ylu98596/telescopic-folding-robotic-arm-gripper/docs/patent-document.pdf

说明书摘要

本发明公开了一种伸缩折叠机械臂夹爪及其伸缩夹持方法，其中一种伸缩折叠

机械臂夹爪，包括：伸缩折叠组件，以及设置在所述伸缩折叠组件上的机械夹

爪基座，所述机械夹爪基座上驱动设置有夹爪组件；所述伸缩折叠组件包括若

干层间隔设置的衔接板，间隔设置的所述衔接板之间预留有间隔区域，每一层

间隔区域内设置有相对设置的展收板组件，间隔设置的所述衔接板通过展收板

组件驱动连接，通过调整展收板组件之间的开合角度调整衔接板之间的间隔区

域的间距，驱动机械夹爪基座实现伸缩折叠。本发明公开了一种结构简单、易

于集成、适应性强且能够实现高精度和快速响应的伸缩折叠机械臂夹爪及其伸

缩夹持方法。

### 摘要附图

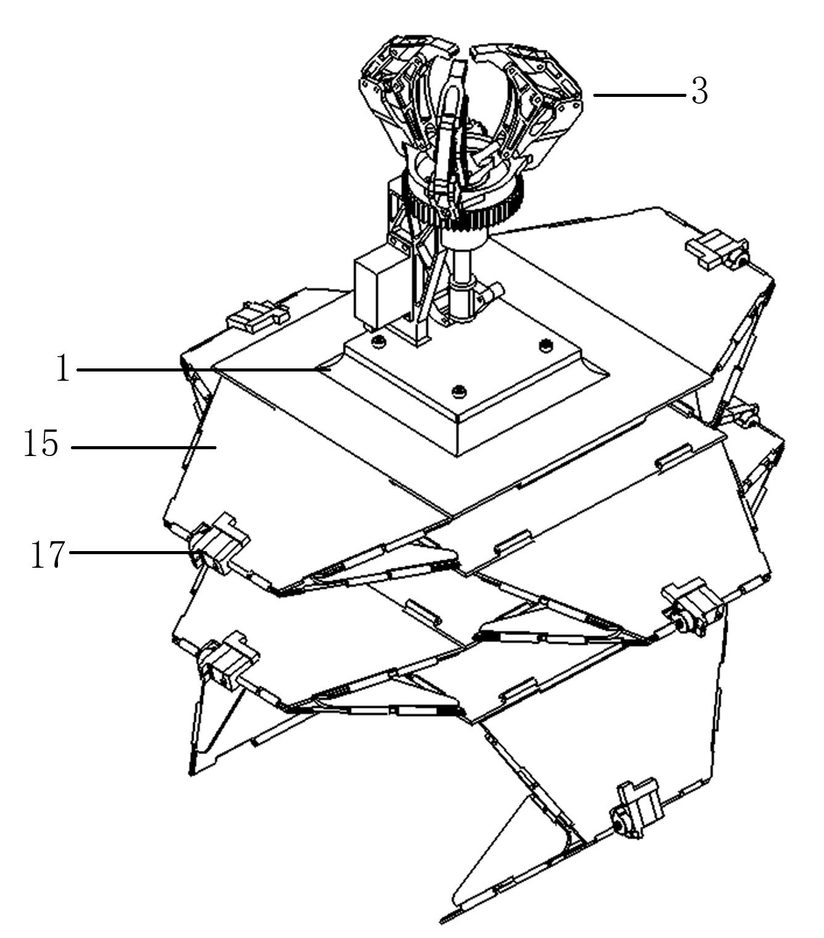
[picture p1: figure]

### 权利要求书

1.一种伸缩折叠机械臂夹爪，其特征在于,包括：伸缩折叠组件，以及设置

在所述伸缩折叠组件上的机械夹爪基座，所述机械夹爪基座上驱动设置有夹爪

组件；

所述伸缩折叠组件包括若干层间隔设置的衔接板，间隔设置的所述衔接板之

间预留有间隔区域，每一层间隔区域内设置有相对设置的展收板组件，间隔设

置的所述衔接板通过展收板组件驱动连接，通过调整展收板组件之间的开合角

度调整衔接板之间的间隔区域的间距，驱动机械夹爪基座实现伸缩折叠。

2.根据权利要求 1 所述的一种伸缩折叠机械臂夹爪，其特征在于：相邻的衔

接板之间的间隔区域的展收板组件交错排布。

3.根据权利要求 2 所述的一种伸缩折叠机械臂夹爪，其特征在于：所述展收

板组件包括通过展收舵机驱动连接的下展收板和上展收板，下展收板和上展收

板的另外一端分别连接间隔布置的衔接板的边沿，通过展收舵机驱动下展收板

和上展收板开合摆动，调整间隔布置的衔接板之间的间隔区域的间距。

4.根据权利要求 3 所述的一种伸缩折叠机械臂夹爪，其特征在于：展收板组

件还包括开合连接的上连接板和下连接板，

所述下展收板和上展收板相对开合的两侧边之间分别通过上连接板和下连

接板枢转连接。

5. 根据权利要求 4 所述的一种伸缩折叠机械臂夹爪，其特征在于：所述衔

接板采用的是方形板；

所述下展收板采用的是上梯形板，所述下连接板采用的是下梯形板，且所述

下展收板的短底边和下连接板的短底边枢转连接，所述下展收板的长底边和下

连接板的长底边分别与对应的衔接板的侧边连接；

所述上连接板采用的是上三角板，所述下连接板采用的是下三角板。

6.根据权利要求 5 所述的一种伸缩折叠机械臂夹爪，其特征在于：所述夹爪

### 权利要求书

组件包括设置在机械夹爪基座上的推拉舵机，所述推拉舵机上驱动连接有推拉

曲柄，推拉曲柄通过推拉臂与夹爪支架的驱动拉杆连接；

所述夹爪支架上设置有旋转舵机以及与所述旋转舵机驱动连接的主动齿轮

和夹爪齿轮；

所示夹爪齿轮上设置有爪座，所述爪座上连接有若干组能相对所述爪座中心

轴线开合的连杆，所述连杆的端部连接有夹爪，所述夹爪和连杆通过三角连杆

与夹爪支架驱动连接。

7.根据权利要求 6 所述的一种伸缩折叠机械臂夹爪，其特征在于：三角连杆

与夹爪支架铰链连接，连杆与爪座铰链连接，爪座与夹爪齿轮固定连接，推

拉曲柄与舵机连接，推拉臂与推拉曲柄、夹爪支架的驱动拉杆铰链。

8.一种伸缩折叠机械臂夹爪的伸缩夹持方法，其特征在于，采用权利要求 1~ 权利要求 7 中任一项所述的一种伸缩折叠机械臂夹爪实现，包括以下步骤：

通过驱动伸缩折叠组件中展收板组件的展收舵机，调整展收舵机连接的上展

收板和下展收板之间的开合角度，进而调整驱动伸缩折叠组件的伸缩形态，驱

动伸缩折叠组件上连接的机械夹爪基座位移至需求位置；

通过驱动机械夹爪基座上的夹爪组件中旋转舵机调整爪座的角度，通过驱动

推拉舵机连接的夹爪支架的驱动拉杆相对夹爪支架伸缩带动连杆、三角连杆、

夹爪联动，实现夹爪组件的夹持和释放。

9.根据权利要求 8 所述的一种伸缩折叠机械臂夹爪的伸缩夹持方法，其特征

在于：当推拉舵机驱动推拉曲柄顺时针旋转，带动推拉臂向上摆动，使夹爪支

架的驱动拉杆向上移动，带动三角连杆向外旋转，从而带动夹爪向外张开，实

现对物体的抓取；

当旋转舵机驱动主动齿轮旋转，带动夹爪齿轮同步旋转，从而带动机械夹

### 权利要求书

爪上部一起旋转，实现夹爪水平角度的调整。

10.根据权利要求 9 所述的一种伸缩折叠机械臂夹爪的伸缩夹持方法，其特

征在于：伸缩折叠组件中每一层包括一对相对设置的展收板组件，相对设置的

展收板组件中的展收舵机分别为左舵机和右舵机；

左舵机的转轴与旋转副连接，使得左舵机同时连接上展收板与下展收板，通

过给左舵机和右舵机分别提供 PWM 信号控制左舵机和右舵机的旋转角度，从而

控制上展收板与下展收板的开合角度。

### 说明书

一种伸缩折叠机械臂夹爪及其伸缩夹持方法

技术领域

本发明涉及机械臂技术领域，具体涉及一种伸缩折叠机械臂夹爪及其伸缩夹

持方法。

背景技术

在自动化和机器人技术中，机械臂的设计和应用至关重要。传统的机械臂往

往采用复杂的气压或液压系统，这些系统不仅结构复杂，占用空间大，不易于

运输和部署，而且对环境的适应性有限，灵活度不足，可重构性较差。

发明内容

本发明克服了现有技术的不足，提供了一种结构简单、易于集成、适应性强

且能够实现高精度和快速响应的伸缩折叠机械臂夹爪及其伸缩夹持方法。

为达到上述目的，本发明采用的技术方案为：一种伸缩折叠机械臂夹爪，包

括：伸缩折叠组件，以及设置在所述伸缩折叠组件上的机械夹爪基座，所述机

械夹爪基座上驱动设置有夹爪组件；所述伸缩折叠组件包括若干层间隔设置的

衔接板，间隔设置的所述衔接板之间预留有间隔区域，每一层间隔区域内设置

有相对设置的展收板组件，间隔设置的所述衔接板通过展收板组件驱动连接，

通过调整展收板组件之间的开合角度调整衔接板之间的间隔区域的间距，驱动

机械夹爪基座实现伸缩折叠。

本发明一个优选的实施方案中，相邻的衔接板之间的间隔区域的展收板组件

交错排布。

本发明一个优选的实施方案中，展收板组件包括通过展收舵机驱动连接的下

展收板和上展收板，下展收板和上展收板的另外一端分别连接间隔布置的衔接

板的边沿，通过展收舵机驱动下展收板和上展收板开合摆动，调整间隔布置的

衔接板之间的间隔区域的间距。

本发明一个优选的实施方案中，展收板组件还包括开合连接的上连接板和下

连接板，所述下展收板和上展收板相对开合的两侧边之间分别通过上连接板和

下连接板枢转连接。

本发明一个优选的实施方案中，衔接板采用的是方形板；所述下展收板采用

的是上梯形板，所述下连接板采用的是下梯形板，且所述下展收板的短底边和

下连接板的短底边枢转连接，所述下展收板的长底边和下连接板的长底边分别

与对应的衔接板的侧边连接；所述上连接板采用的是上三角板，所述下连接板

采用的是下三角板。

本发明一个优选的实施方案中，夹爪组件包括设置在机械夹爪基座上的推拉

舵机，所述推拉舵机上驱动连接有推拉曲柄，推拉曲柄通过推拉臂与夹爪支架

的驱动拉杆连接；

所述夹爪支架上设置有旋转舵机以及与所述旋转舵机驱动连接的主动齿轮

和夹爪齿轮；

所示夹爪齿轮上设置有爪座，所述爪座上连接有若干组能相对所述爪座中心

轴线开合的连杆，所述连杆的端部连接有夹爪，所述夹爪和连杆通过三角连杆

与夹爪支架驱动连接。

本发明一个优选的实施方案中，三角连杆与夹爪支架铰链连接，连杆与爪

座铰链连接，爪座与夹爪齿轮固定连接，推拉曲柄与舵机连接，推拉臂与推

拉曲柄、夹爪支架的驱动拉杆铰链。

本发明一个优选的实施方案中，一种伸缩折叠机械臂夹爪的伸缩夹持方法，

采用一种伸缩折叠机械臂夹爪实现，包括以下步骤：

通过驱动伸缩折叠组件中展收板组件的展收舵机，调整展收舵机连接的上展

收板和下展收板之间的开合角度，进而调整驱动伸缩折叠组件的伸缩形态，驱

动伸缩折叠组件上连接的机械夹爪基座位移至需求位置；

通过驱动机械夹爪基座上的夹爪组件中旋转舵机调整爪座的角度，通过驱动

推拉舵机连接的夹爪支架的驱动拉杆相对夹爪支架伸缩带动连杆、三角连杆、

夹爪联动，实现夹爪组件的夹持和释放。

本发明一个优选的实施方案中，当推拉舵机驱动推拉曲柄顺时针旋转，带动

推拉臂向上摆动，使夹爪支架的驱动拉杆向上移动，带动三角连杆向外旋转，

从而带动夹爪向外张开，实现对物体的抓取；当旋转舵机驱动主动齿轮旋转，

带动夹爪齿轮同步旋转，从而带动机械夹爪上部一起旋转，实现夹爪水平角

度的调整。

本发明一个优选的实施方案中，伸缩折叠组件中每一层包括一对相对设置的

展收板组件，相对设置的展收板组件中的展收舵机分别为左舵机和右舵机；

左舵机的转轴与旋转副连接，使得左舵机同时连接上展收板与下展收板，通

过给左舵机和右舵机分别提供 PWM 信号控制左舵机和右舵机的旋转角度，从而

控制上展收板与下展收板的开合角度。

本发明解决了技术背景中存在的缺陷，本发明有益的技术效果是：

一种伸缩折叠机械臂夹爪及其伸缩夹持方法，采用 PWM 信号控制伸缩折叠机

械臂夹爪的机械夹爪，能与外部设备互联实现人机交互，具有优异的自适应功

能。

1、本发明的伸缩折叠机械臂夹爪的结构简单，机械臂可活动范围大，移动

灵活。

2、本发明的伸缩折叠机械臂夹爪的折叠结构易于堆叠集成，不需要依赖气

压和液压系统的管路、阀门，也无需磁驱动所需的外部磁场。

3、本发明的伸缩折叠机械臂夹爪的控制方式简单，通过 PWM 信号控制动作，

降低了现有技术中机械臂夹爪的结果复杂性。

4、本发明的伸缩折叠机械臂夹爪适应性强，不受磁场强度、液压流量、压

力、环境温度等因素的影响；能实现高精度和快速响应，满足自动化和机器

人技术的需求，节约人力、物力、财力。

附图说明

下面结合附图和实施例对本发明进一步说明。

图 1 为本发明的优选实施例的一种可伸缩的折叠机械臂夹爪的机械夹爪结构

示意图；

图 2 为本发明的优选实施例的一种可伸缩的折叠机械臂夹爪的机械臂一个折

叠单元的结构示意图；

图 3 为本发明的优选实施例的一种可伸缩的折叠机械臂夹爪的机械臂结构示

意图；

图 4 为本发明的优选实施例的一种可伸缩的折叠机械臂夹爪的机械臂伸缩后

的结构示意图；

图 5 为本发明的优选实施例的一种可伸缩的折叠机械臂夹爪的机械臂伸缩后

的正视图；

图 6 为本发明的优选实施例的一种可伸缩的折叠机械臂夹爪的人机交互控制

流程图；

图 7 为本发明的优选实施例的手势识别与视觉反馈系统架构图；

图 8 为本发明的优选实施例的两个正方形板中心与两个舵机的二维切面图。

图中标号说明：1、机械夹爪基座；2、夹爪支架；3、夹爪；4、三角连杆；

5、连杆；6、爪座；7、主动齿轮；8、夹爪齿轮；9、旋转舵机；10、推拉舵机；

11、推拉曲柄；12、推拉臂；13、右舵机；14、衔接板；15、上展收板；16、

上连接板；17、左舵机；18、下展收板；19、下连接板。

具体实施方式

现在结合附图和实施例对本发明作进一步详细的说明，这些附图均为简化的

示意图，仅以示意方式说明本发明的基本结构，因此其仅显示与本发明有关的

构成。

需要说明，若本发明实施例中有涉及方向性指示(诸如上、下、底、顶等)，

则该方向性指示仅用于解释在某一特定姿态下各部件之间的相对位置关系、运

动情况等，如果该特定姿态发生改变时，则该方向性指示也相应地随之改变。

术语“第一”、“第二”仅用于描述目的，而不能理解为指示或暗示相对重要

性或者隐含指明所指示的技术特征的数量。由此，限定有“第一”、“第二”

的特征可以明示或者隐含地包括一个或者更多个该特征。除非另有明确的规定

和限定，术语“设置”、“相连”、“连接”应做广义理解，例如，可以是固

定连接，也可以是可拆卸连接，或一体地连接；可以是直接相连，也可以通过

中间媒介间接相连，可以是两个元件内部的连通。对于本领域的普通技术人员

而言，可以具体情况理解上述术语在本发明中的具体含义。

实施例一，如图 1-图 6 所示，一种伸缩折叠机械臂夹爪，包括：伸缩折叠组

件，以及设置在所述伸缩折叠组件上的机械夹爪基座 1，所述机械夹爪基座 1 上

驱动设置有夹爪组件。

具体的，伸缩折叠组件包括若干层间隔设置的衔接板 14，间隔设置的所述衔

接板 14 之间预留有间隔区域，每一层间隔区域内设置有相对设置的展收板组件，

间隔设置的所述衔接板 14 通过展收板组件驱动连接，通过调整展收板组件之间

的开合角度调整衔接板 14 之间的间隔区域的间距，驱动机械夹爪基座 1 实现伸

缩折叠。

展收板组件包括通过展收舵机驱动连接的下展收板 18 和上展收板 15，开合

连接的上连接板 16 和下连接板 19。下展收板 18 和上展收板 15 的另外一端分别

连接间隔布置的衔接板 14 的边沿，通过展收舵机驱动下展收板 18 和上展收板

15 开合摆动，调整间隔布置的衔接板 14 之间的间隔区域的间距。所述下展收板

18 和上展收板 15 相对开合的两侧边之间分别通过上连接板 16 和下连接板 19 枢

转连接。本实施例中，衔接板 14 采用的是方形板；所述下展收板 18 采用的是

上梯形板，所述下连接板 19 采用的是下梯形板，且所述下展收板 18 的短底边

和下连接板 19 的短底边枢转连接，所述下展收板 18 的长底边和下连接板 19 的

长底边分别与对应的衔接板 14 的侧边连接；所述上连接板 16 采用的是上三角

板，所述下连接板 19 采用的是下三角板。

具体的，夹爪组件包括设置在机械夹爪基座 1 上的推拉舵机 10，所述推拉舵

机 10 上驱动连接有推拉曲柄 11，推拉曲柄 11 通过推拉臂 12 与夹爪支架 2 的驱

动拉杆连接；所述夹爪支架 2 上设置有旋转舵机 9 以及与所述旋转舵机 9 驱动

连接的主动齿轮 7 和夹爪齿轮 8；所示夹爪齿轮 8 上设置有爪座 6，所述爪座 6

上连接有若干组能相对所述爪座 6 中心轴线开合的连杆 5，所述连杆 5 的端部连

接有夹爪 3，所述夹爪 3 和连杆 5 通过三角连杆 4 与夹爪支架 2 的驱动拉杆驱动

连接。其中，三角连杆 4 与夹爪支架 2 的驱动拉杆的一端铰链连接，连杆 5 与

爪座 6 铰链连接，爪座 6 与夹爪齿轮 8 固定连接，推拉曲柄 11 与推拉舵机 10

连接，推拉臂 12 与推拉曲柄 11、夹爪支架 2 的驱动拉杆的另一端铰链。

实施例二，在实施例一的基础上，相邻的衔接板 14 之间的间隔区域的展收板组

件交错排布。

实施例三，进一步的，本实施例二的基础上，力传感器型号选用现有技术中

的 TekscanFlexiForceA201 力传感器，安装在嵌入夹爪 3 的抓取面内侧。本实

施例中还设置有与伸缩折叠机械臂夹爪对应的深度摄像头，用于采集伸缩折叠

机械臂夹爪的姿态，深度摄像头型号选用 IntelRealSenseD455 深度摄像头，安

装在机械夹爪基座 1 的侧下方，镜头轴线与夹爪 3 中心线成 15°俯角。

实施例四，在实施例一或实施例二的基础上，一种伸缩折叠机械臂夹爪的伸

缩夹持方法，采用一种伸缩折叠机械臂夹爪实现，包括以下步骤：

通过驱动伸缩折叠组件中展收板组件的展收舵机，调整展收舵机连接的上展

收板 15 和下展收板 18 之间的开合角度，进而调整驱动伸缩折叠组件的伸缩形

态，驱动伸缩折叠组件上连接的机械夹爪基座 1 位移至需求位置。具体的，伸

缩折叠组件中每一层包括一对相对设置的展收板组件，相对设置的展收板组件

中的展收舵机分别为左舵机 17 和右舵机 13；左舵机 17 的转轴与旋转副连接，

使得左舵机 17 同时连接上展收板 15 与下展收板 18，通过给左舵机 17 和右舵机

13 分别提供 PWM 信号控制左舵机 17 和右舵机 13 的旋转角度，从而控制上展收

板 15 与下展收板 18 的开合角度。

通过驱动机械夹爪基座 1 上的夹爪组件中旋转舵机 9 调整爪座 6 的角度，通

过驱动推拉舵机 10 的夹爪支架 2 的驱动拉杆伸缩带动连杆 5、三角连杆 4、夹

爪 3 联动，实现夹爪组件的夹持和释放。具体的，当推拉舵机 10 驱动推拉曲柄

11 顺时针旋转，带动推拉臂 12 向上摆动，使夹爪支架 2 的驱动拉杆相对夹爪支

架 2 向上移动，带动三角连杆 4 向外旋转，从而带动夹爪 3 向外张开，实现对

物体的抓取；当旋转舵机 9 驱动主动齿轮 7 旋转，带动夹爪齿轮 8 同步旋转，

从而带动伸缩折叠机械臂夹爪上部一起旋转，实现夹爪 3 的水平角度的调整。

进一步的，左舵机 17 和右舵机 13 的旋转角度与上展收板 15 与下展收板 18

之间的夹角变化角度相等。伸缩实现：PWM 信号同时控制左舵机 17 与右舵机

13，控制两梯形板夹角一致切变化一致，实现折叠伸缩。弯曲实现：PWM 信号

同时控制左舵机 17 与右舵机 13，左舵机 17 使左边两梯形板夹角减小而右舵

机 13 使左边两梯形板夹角减小，从而实现左弯曲；右弯曲则反之；前后弯曲

则在上方或下方另一个维度的折叠单元上实现，从而达成 360°无死角的弯

曲。上连接板 16 与下连接板 19 在机械臂运动过程中辅助支撑，分担受力，

提升结构的稳定性。PWM 信号控制展收舵机（如从上到下所有的舵机）同时变

化相同角度实现快速伸缩弯曲。

实施例五，在实施例四的基础上，一种伸缩折叠机械臂夹爪的伸缩夹持方法，

采用一种伸缩折叠机械臂夹爪实现，还包括：

将单个元件理想化为一个旋转、伸缩的连杆，定义机械臂为四轴串联，求出

舵机角度与末端坐标的变换公式。以每个正方形的衔接板中心为坐标原点，垂

直于正方形的衔接板的为 z 轴正向；正视时，如图 5 中垂直于图片向外的为 y

轴，x 轴依照右手定则。相邻两块正方形板的衔接板的中心点位的连线作为算法

中的虚拟连杆，所有α角（包括α1、α2、α3、α4等）是相应层的正方形的衔

接板上的 z 轴与相应虚拟连杆之间的夹角，所有 l（包括 l1、l2、l3、l4等）是

相应虚拟连杆的长度。

第一个虚拟连杆：绕 x 轴旋转角度为α1，沿 z 轴伸缩长度为 l1；

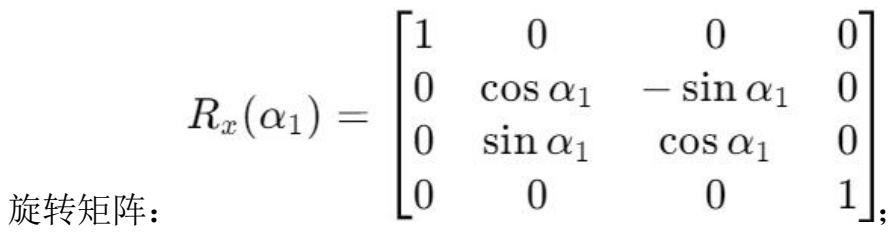
[picture p2: figure]
旋转矩阵：
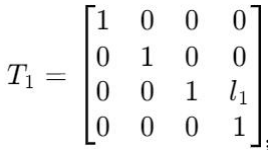
[picture p3: figure]

平移矩阵： | ；变换矩阵： | 。

第二个虚拟连杆：绕新的 y 轴旋转角度为α2，沿新 z 轴伸缩长度为 l2；

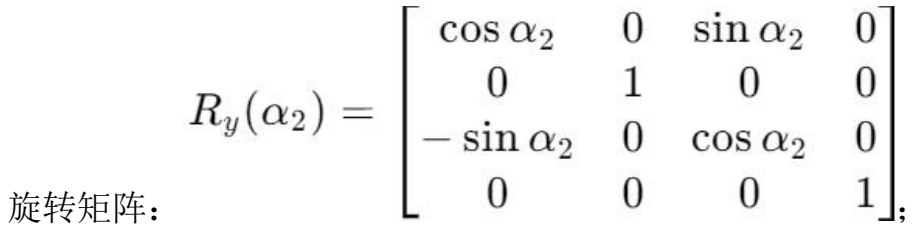
[picture p4: figure]
旋转矩阵：

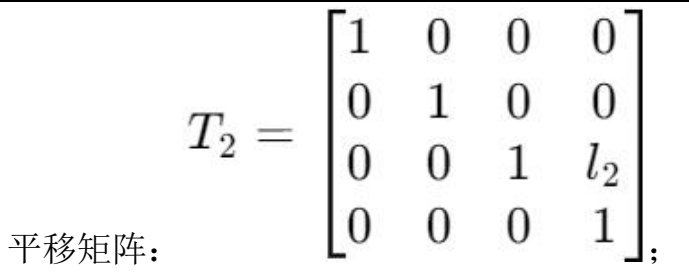
[picture p5: figure]
平移矩阵：

变换矩阵： | 。

第三个虚拟连杆：绕新的 x 轴旋转角度为α3，沿新 z 轴伸缩长度为 l3；

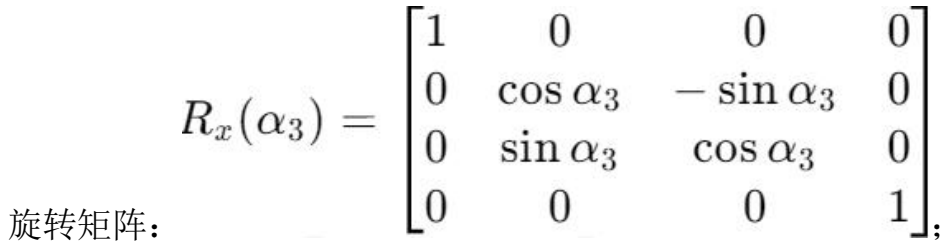
[picture p6: figure]
旋转矩阵：
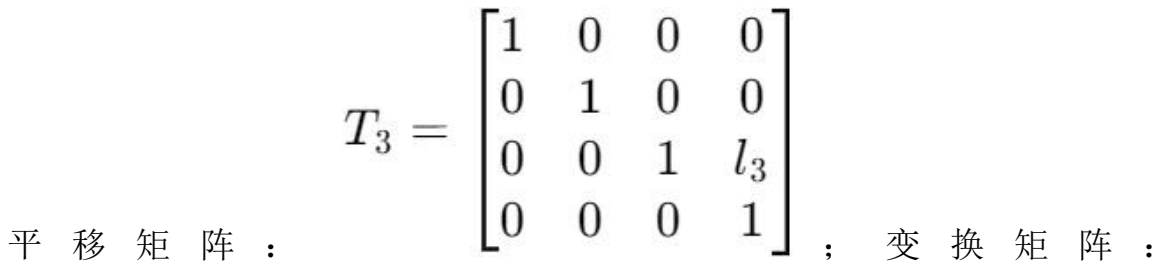
[picture p7: figure]

。

第四个虚拟连杆：绕新的 y 轴旋转角度为α4，沿新 z 轴伸缩长度为 l4；

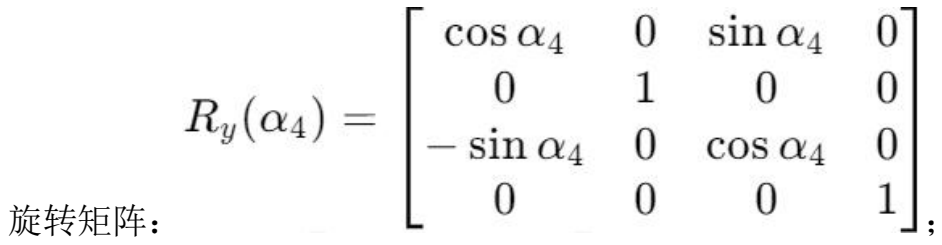
[picture p8: figure]
旋转矩阵：
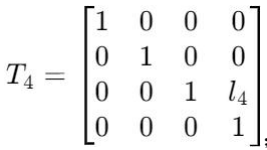
[picture p9: figure]

平移矩阵： | ；变换矩阵： | 。
从基座到末端执行器的总变换矩阵为： | ；
末端执行器坐标 | 为总变换矩阵 | 中前 3 行第 4 列的元素，

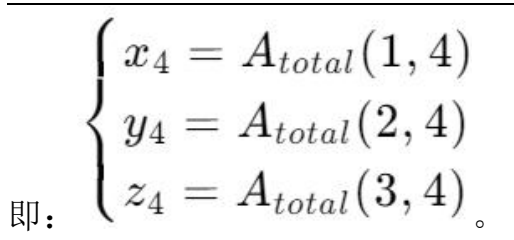
[picture p10: figure]

具体拟合推导数据如下：

对于单个元件，两个正方形板中心与两个舵机的二维切面图，如图 8 所示：

已知：AF=AB=CD=DE=a，BC=EF=b，O1M1=O1N1=c；∠FAB=θ1，∠EDC=θ 2；O1M1与 O1N1

分别是 BC 与 EF 的中垂线；

则，FH= | ÷
ø

ö
ç
è

æ
- 2

## a sin

θ1 ，EL= | ÷
ø

ö
ç
è

æ
- 2

## a sin

θ 2

；

则，N1K= | ú
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
## sin

2

## sin

2

a | θ1 | θ 2
；
则，M1N1=2N1K= | ú
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
## sin

2

## a sin

θ1 | θ 2 | , sin ∠N1O1D=N1K/O1N1= | ú

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
## sin

2

## sin

2

a | θ1 | θ 2
c
；
则∠N1O1D= | þ
| | ý

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
- - | 2

## sin

2

## sin

2

## sin

1 | θ1 | θ 2
c

a

；

由于虚拟连杆 1 为 M1N1；

α1 =- ∠ O1M1N1= ∠ N1O1D
2

π
- | = | þ ý

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
- - | 2

sin
2

sin
2

sin

1 | θ1 | θ 2
c

a
2

π
- ；

1

l =M1N1= | ú û

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
a sin

θ1 θ 2
；

以此类推：
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
æ = | · - | 2
sin
2

sin
2

sin

1 | 2
n
n | n c
a | θ | θ
α
2

π
- ； | ú
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
n | n

l a

θ | θ | ，

（n=1，2，3，4）；将
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
æ = | · - | 2
sin
2

sin
2

sin

1 | 2
n
n | n c
a | θ | θ
α | 与 | ú
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
n | n

l a

θ θ

求到的α n与 n

l 带入由各舵机夹角求出末端坐标的公式：

x4=l1sinα2sinα4cosα3+l2sinα4cosα3+l3sinα4cosα3+l4sinα4cosα3；

y4=l1(sinα1cosα2sinα4cosα3-cosα1sinα2sinα4cosα3)+l2(sinα1sinα

4cosα3+cosα1cosα4cosα3）+l3(sinα1sinα4cosα3+cosα1cosα4cosα3）

+l4(sinα1sinα4cosα3+cosα1cosα4cosα3）；

z4=l1(cosα1cosα2sinα4cosα3+sinα1sinα2sinα4cosα3)+l2(cosα1sinα

4cosα3-sinα1cosα4cosα3）+l3(cosα1sinα4cosα3-sinα1cosα4cosα3）

+l4(cosα1sinα4cosα3-sinα1cosα4cosα3）；

算出末端坐标 | 。

工作原理：

本发明提供了一种伸缩折叠机械臂夹爪及其伸缩夹持方法，包括机械夹爪、

折叠结构机械臂、舵机驱动单元及智能控制系统。折叠结构由多个铰接的正

方形板、梯形板和三角形板组成，通过 PWM 信号控制舵机驱动折叠单元伸缩、

弯曲和折叠，实现机械臂的高自由度运动。本发明采用 PWM 信号控制左舵机

使左边两梯形板夹角减小而右舵机使左边两梯形板夹角减小，从而实现左弯

曲；右弯曲则反之；前后弯曲则在上方或下方另一个维度的折叠单元上实现，

从而达成 360°无死角的弯曲。机械臂运动过程中辅助支撑，分担受力，提升

结构的稳定性。

本发明结构简单，机械臂可活动范围大，移动灵活；折叠结构易于堆叠集

成，而不需要气压和液压系统中的管路、阀门等复杂装置，也无需磁驱动所

需的外部磁场；控制系统简单，通过 PWM 信号即可实现精确控制降低了复杂

性；适应性强，不受磁场强度、液压流量、压力、环境温度等因素的影响；

能实现高精度和快速响应，满足自动化和机器人技术的需求，节约人力、物

力、财力。

以上具体实施方式是对本发明提出的方案思想的具体支持，不能以此限定本

发明的保护范围，凡是按照本发明提出的技术思想，在本技术方案基础上所做

的任何等同变化或等效的改动，均仍属于本发明技术方案保护的范围。

### 说明书附图

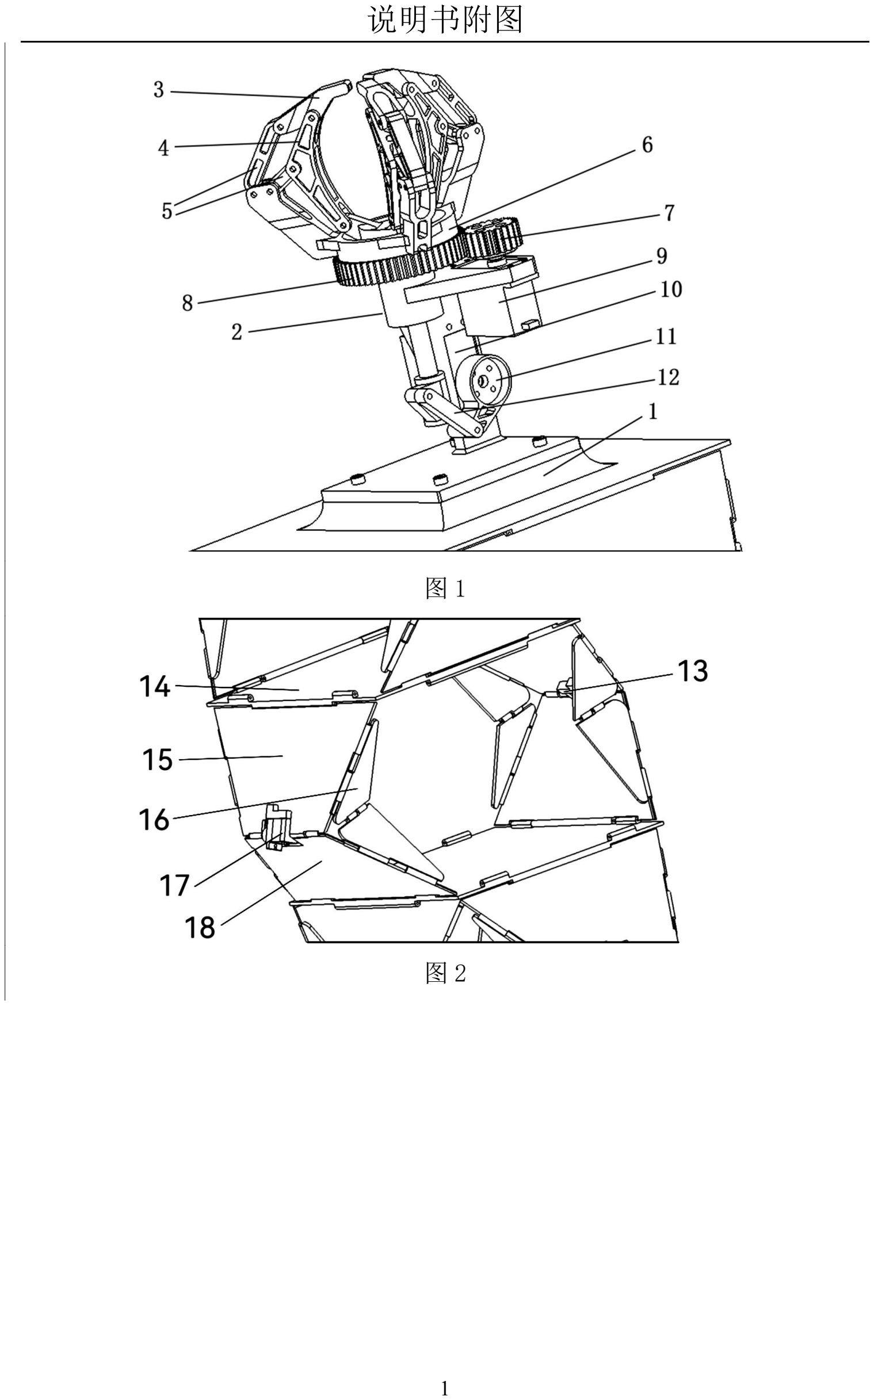
[picture p11: page 18]

图 1

图 2

### 说明书附图

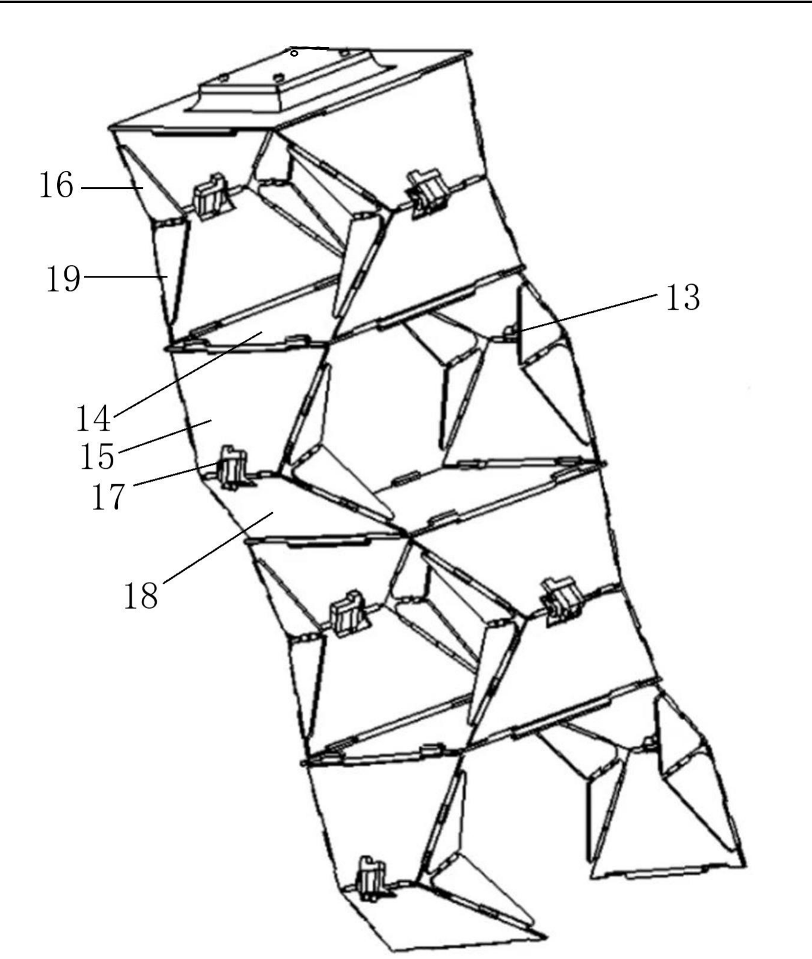
[picture p12: figure]

图 3

### 说明书附图

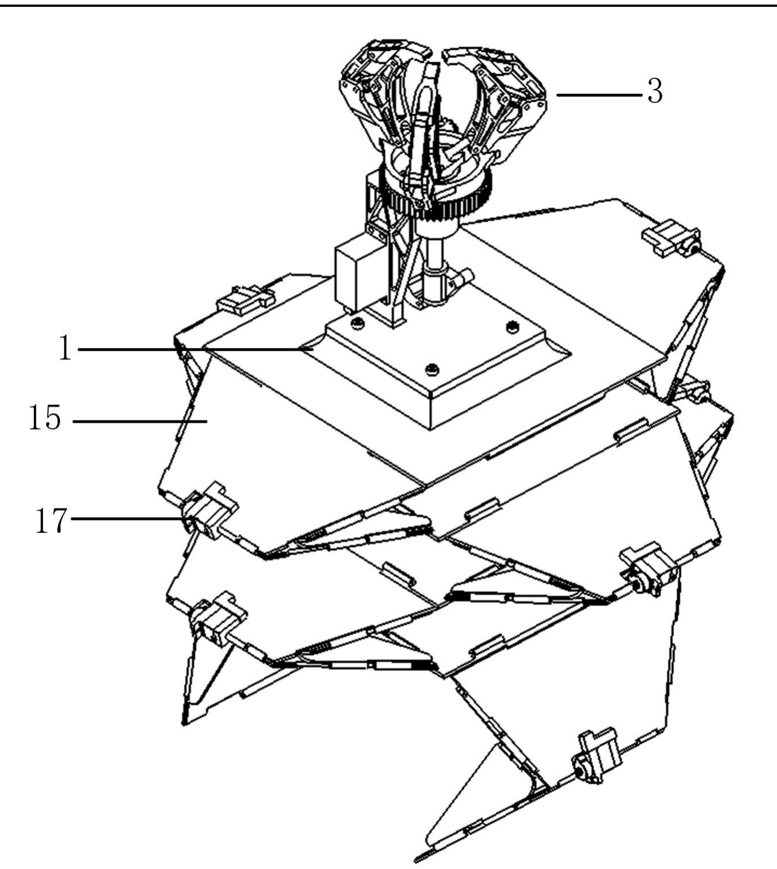
[picture p13: figure]

图 4

### 说明书附图

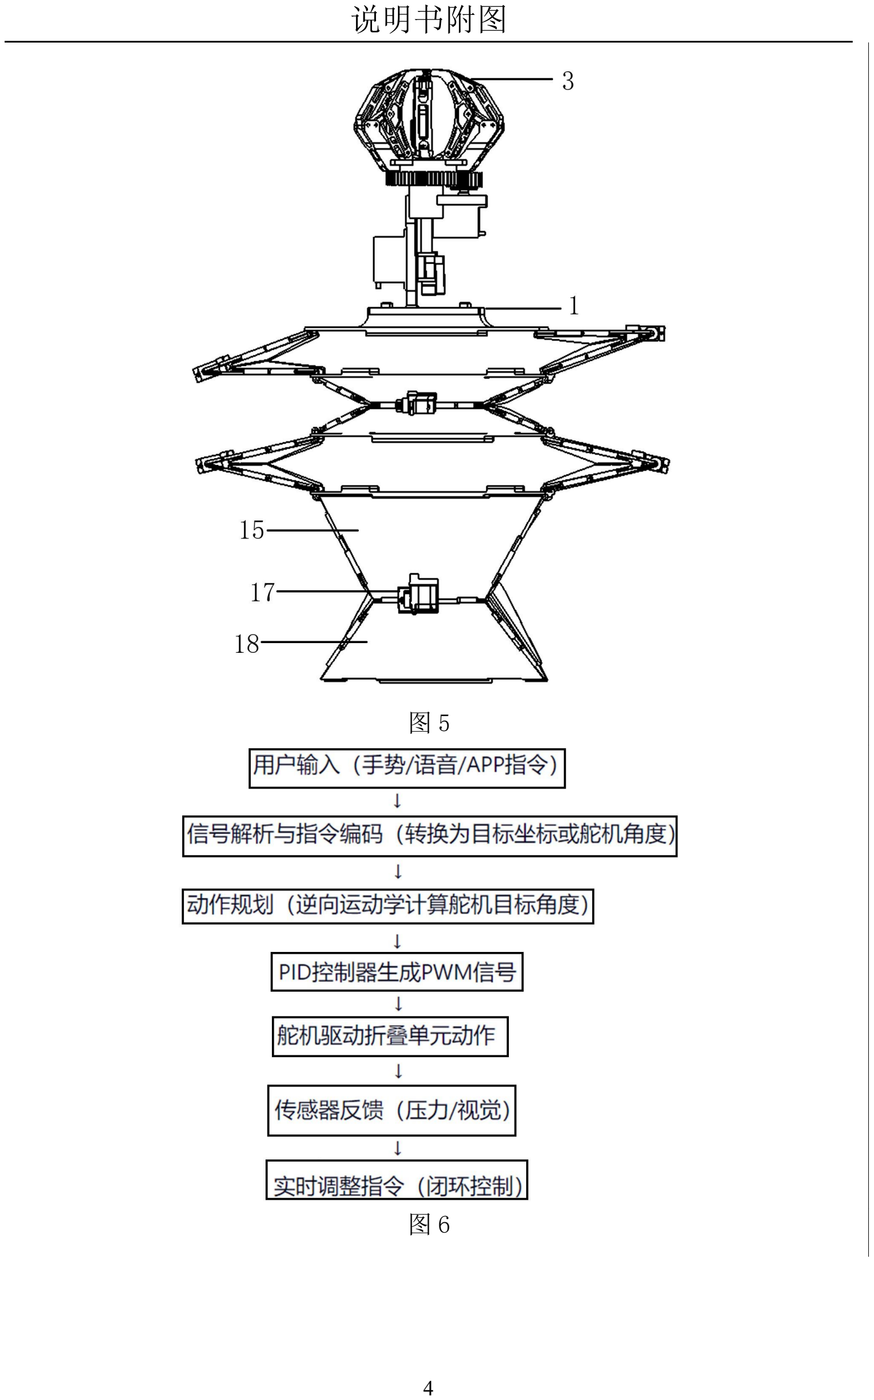
[picture p14: page 21]

图 5

图 6

### 说明书附图

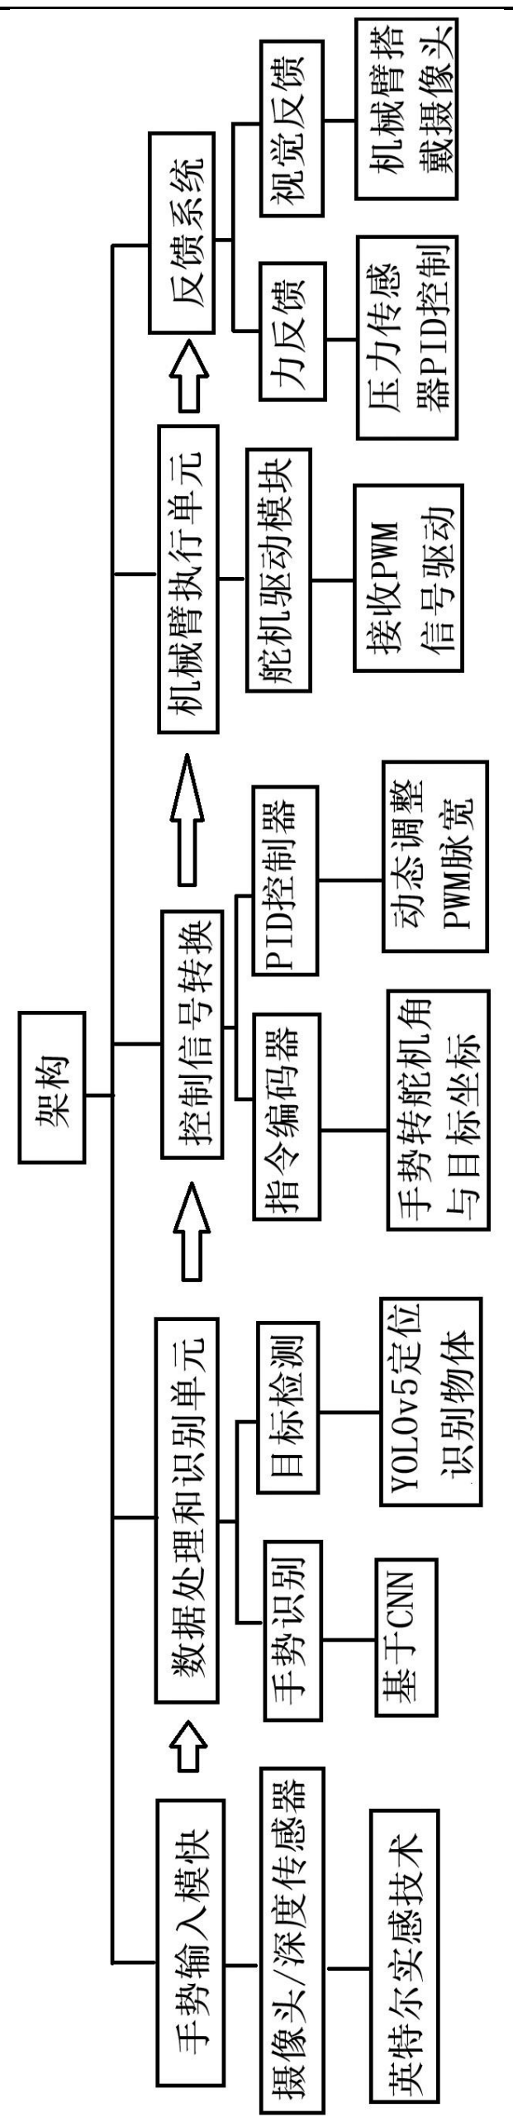
[picture p15: figure]

图 7

### 说明书附图

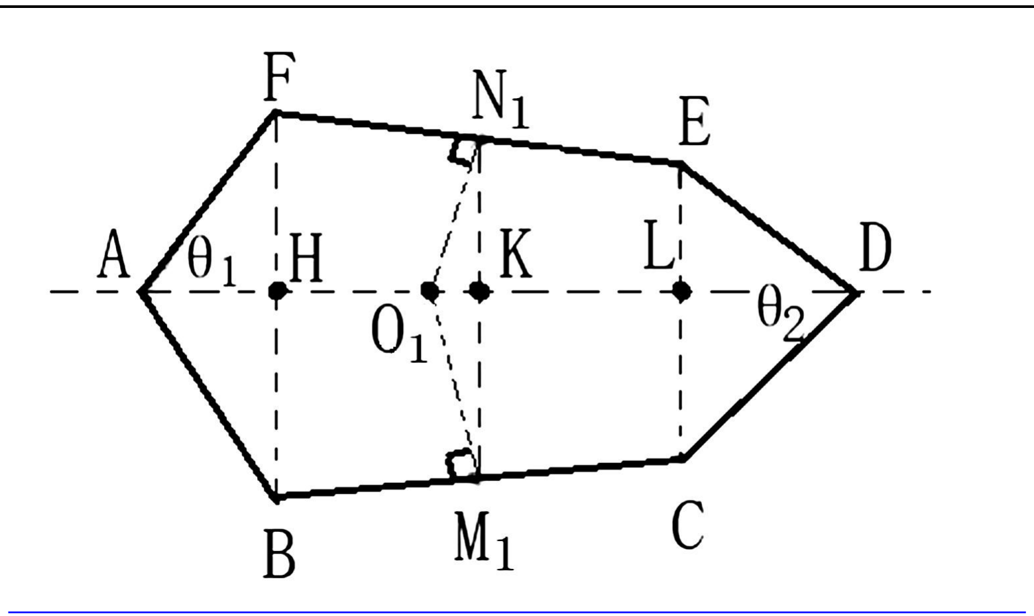
[picture p16: figure]

图 8
