ylu98596/telescopic-folding-robotic-arm-gripper/docs/patent-certificate.pdf

# 发 明 专 利 证 书

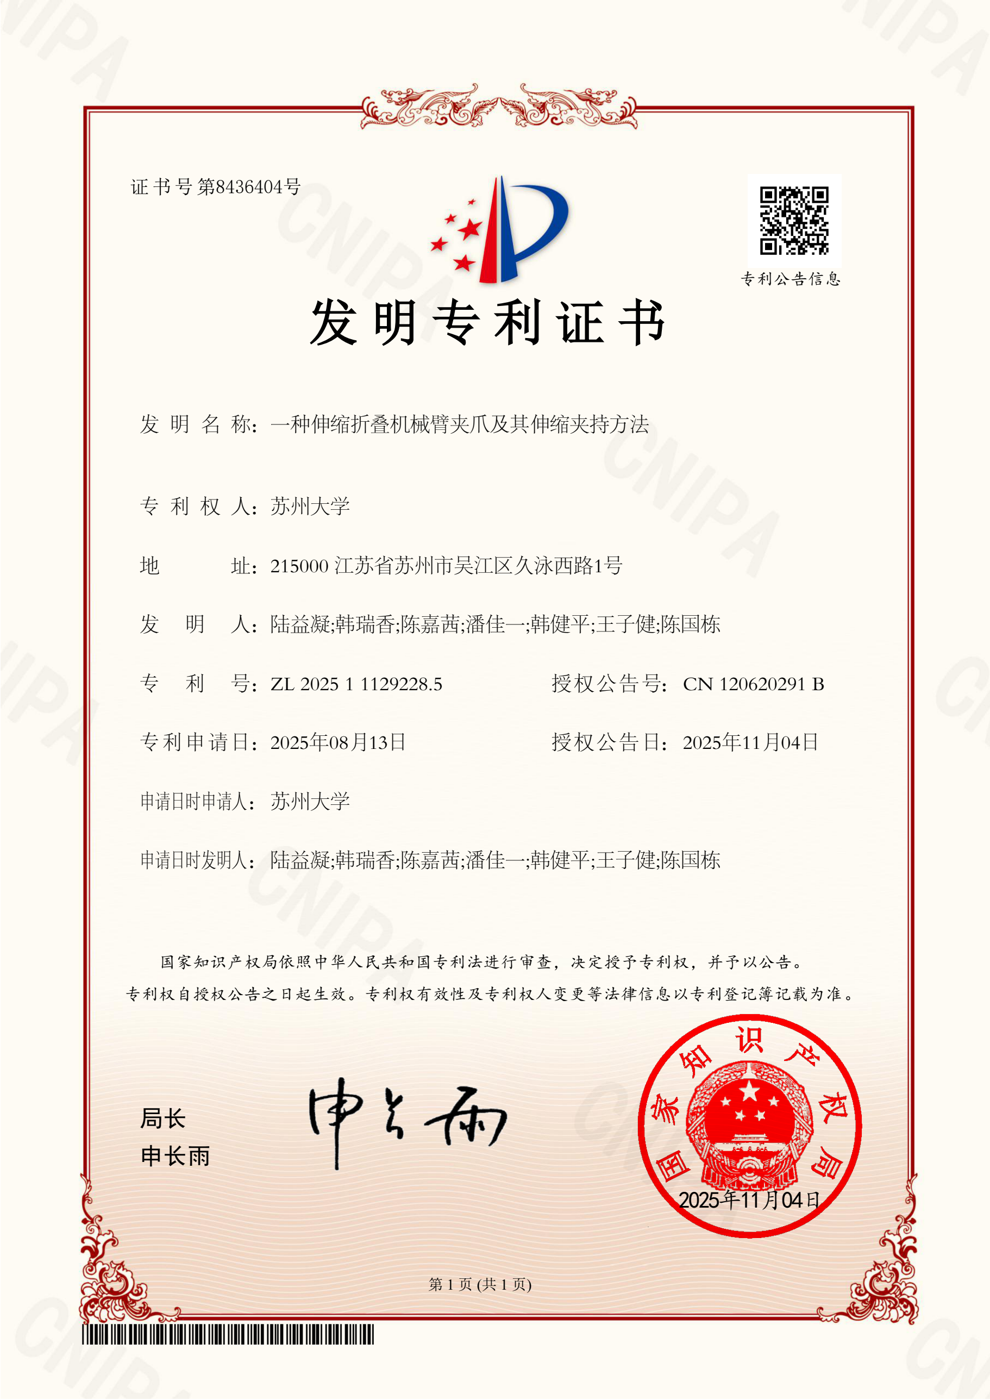
[picture p17: page 1]

第 1 页 (共 1 页)

证书号 第8436404号

专利公告信息

发 明 名 称：一种伸缩折叠机械臂夹爪及其伸缩夹持方法

专 利 权 人：苏州大学

地 | 址：215000 江苏省苏州市吴江区久泳西路1号
发 | 明 | 人：陆益凝;韩瑞香;陈嘉茜;潘佳一;韩健平;王子健;陈国栋
专 | 利 | 号：ZL 2025 1 1129228.5 | 授权公告号： CN 120620291 B
专 利 申 请 日：2025年08月13日 | 授权公告日： 2025年11月04日

申请日时申请人： 苏州大学

申请日时发明人： 陆益凝;韩瑞香;陈嘉茜;潘佳一;韩健平;王子健;陈国栋

国家知识产权局依照中华人民共和国专利法进行审查，决定授予专利权，并予以公告。

专利权自授权公告之日起生效。专利权有效性及专利权人变更等法律信息以专利登记簿记载为准。

局长
申长雨

2025年11月04日

*2025111292285*
