ylu98596/telescopic-folding-robotic-arm-gripper/images/1.png

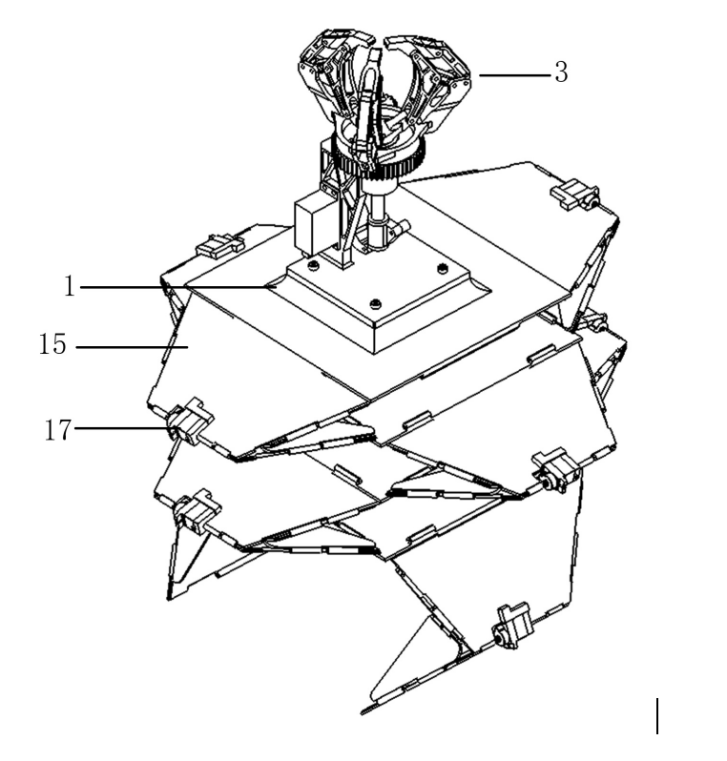
images/1.png
