ylu98596/telescopic-folding-robotic-arm-gripper/images/2.png

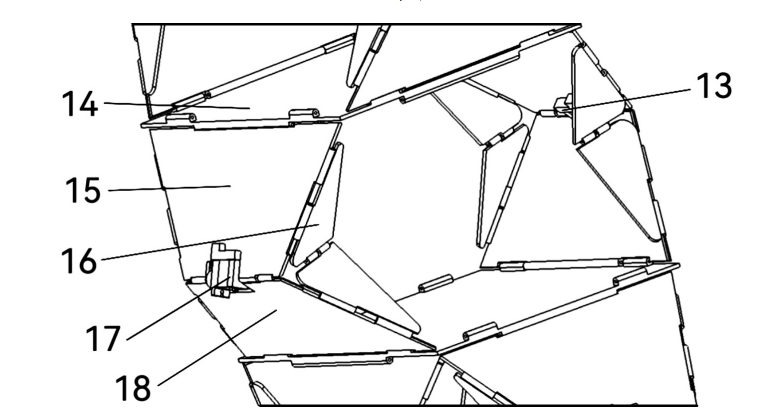
images/2.png
