ylu98596/telescopic-folding-robotic-arm-gripper/images/3.png

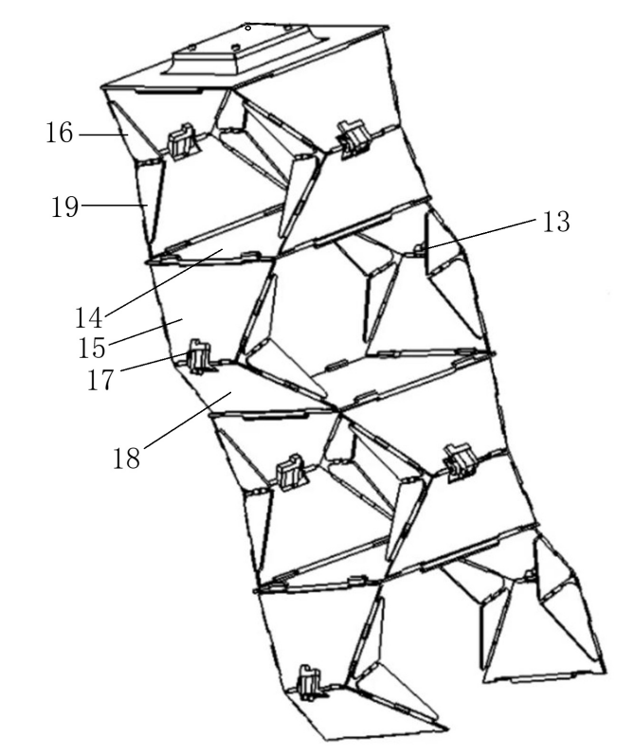
images/3.png
