ylu98596/telescopic-folding-robotic-arm-gripper/images/4.png

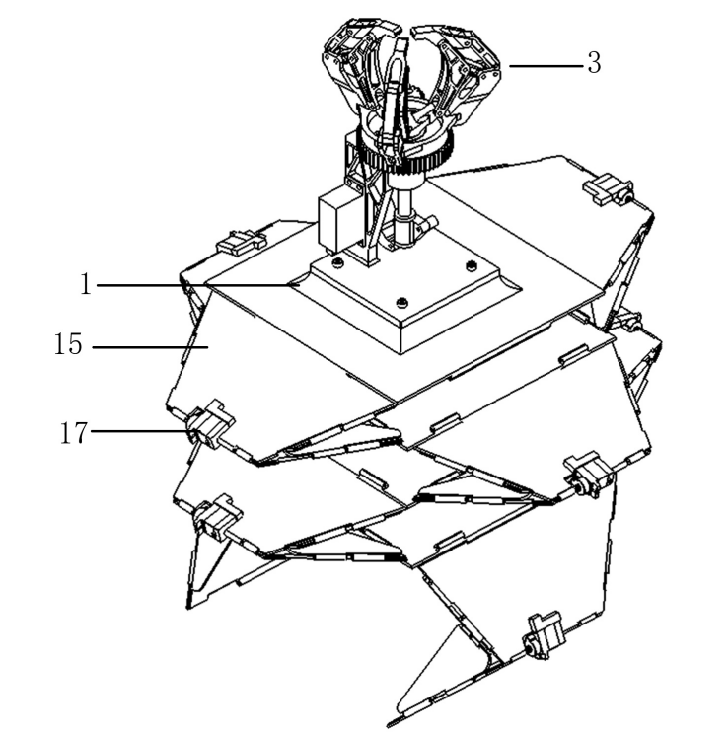
images/4.png
