ylu98596/telescopic-folding-robotic-arm-gripper/images/5.png

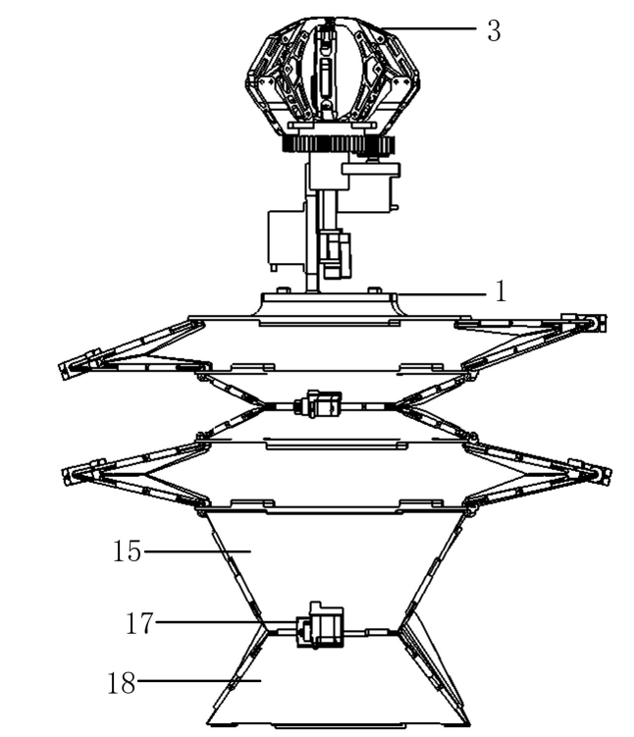
images/5.png
