ylu98596/telescopic-folding-robotic-arm-gripper/SW/机械臂.SLDASM

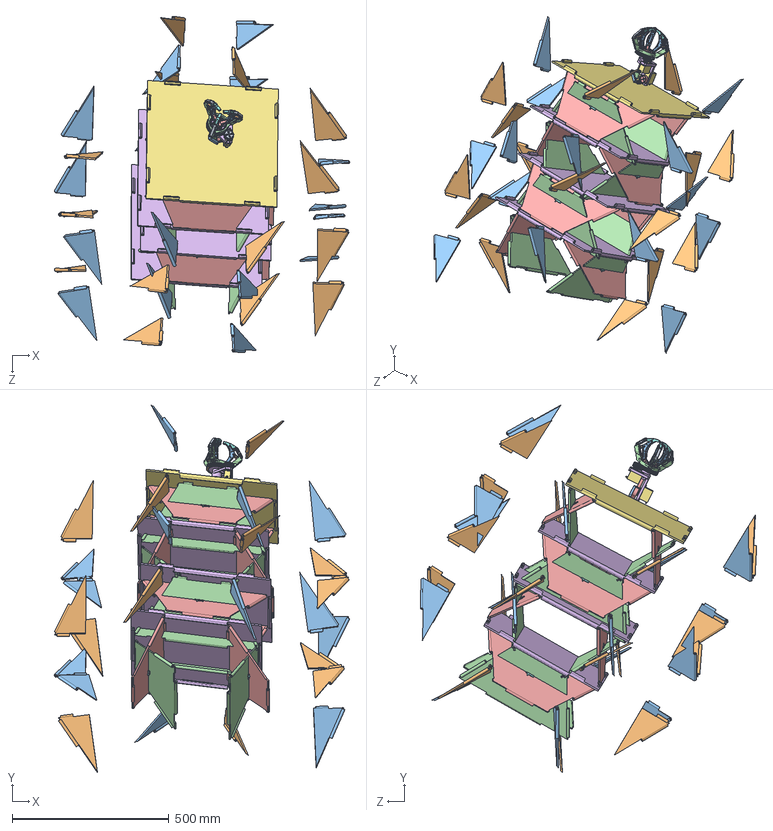
[picture p23: CAD file, 2026-10-07]
SW/机械臂.SLDASM
941.8 x 1172.7 x 1072.2 mm
正方形中间层 x 3
梯形上 x 8
梯形下 x 8
三角上 x 16
三角下 x 16
舵机架 x 8
9g舵机 x 8
正方形顶盖
机架 x 2
爪支架
爪座
三角连杆 x 3
连杆1 x 3
连杆2 x 3
草图 x 3
MG996舵机 x 2
舵盘 x 2
推拉曲柄
推拉臂
推拉臂2
圆柱齿轮55×1.25
圆柱齿轮23×1.25
