ylu98596/telescopic-folding-robotic-arm-gripper/SW/机械手臂/折叠机构部件2.SLDASM

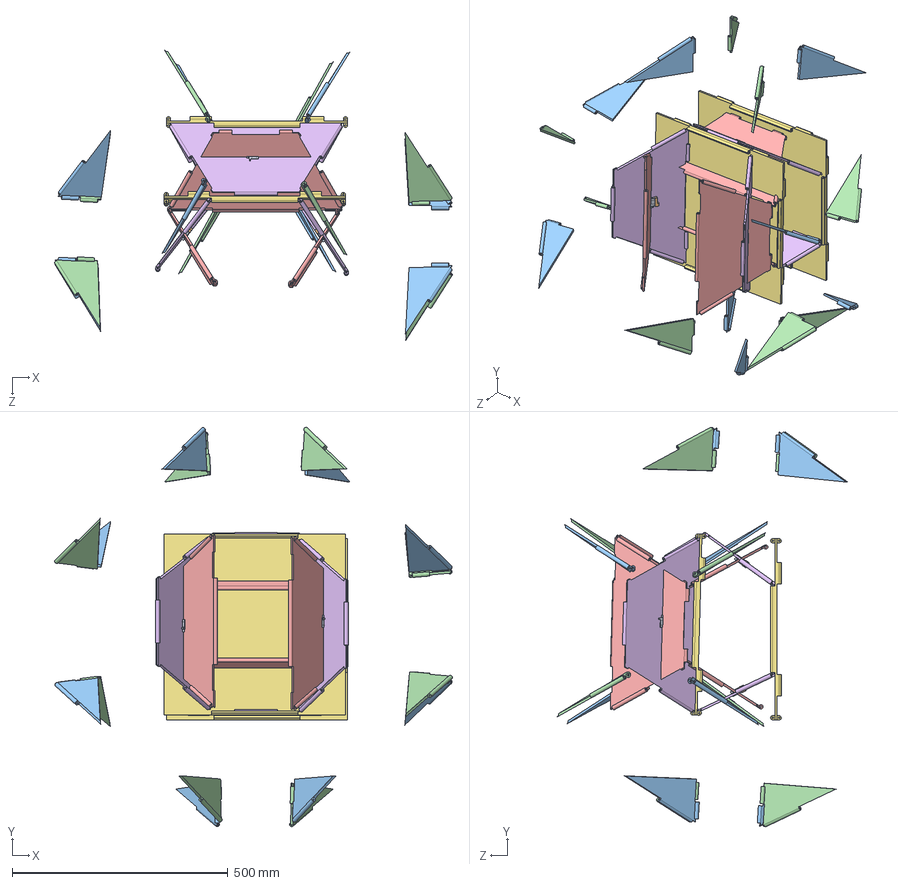
[picture p24: CAD file, 2026-10-07]
SW/机械手臂/折叠机构部件2.SLDASM
921.9 x 925.5 x 672.6 mm
正方形中间层 x 2
梯形上 x 4
梯形下 x 4
三角上 x 8
三角下 x 8
舵机架 x 4
9g舵机 x 4
