ylu98596/telescopic-folding-robotic-arm-gripper/SW/机械夹爪/机械手装配.SLDASM

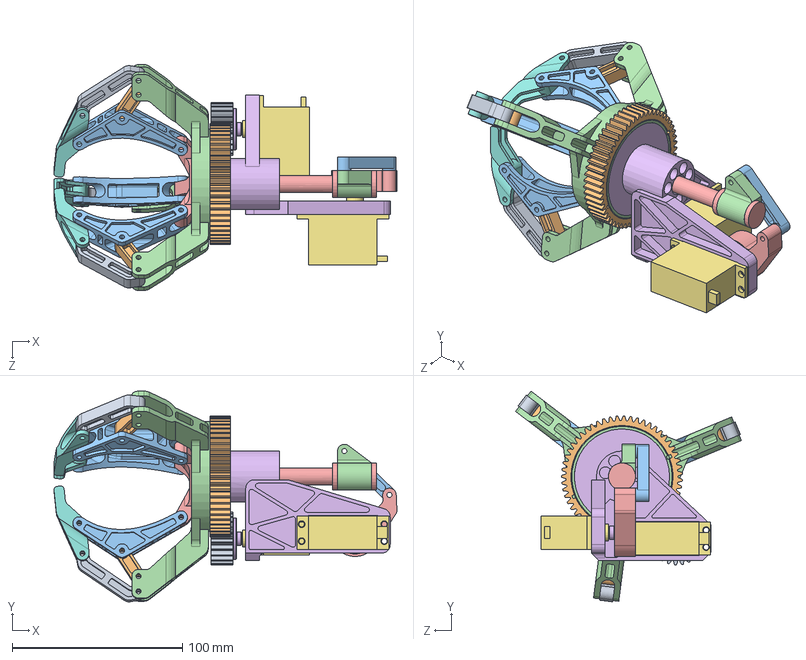
[picture p25: CAD file, 2026-10-07]
SW/机械夹爪/机械手装配.SLDASM
201.7 x 123.9 x 132.8 mm
机架 x 2
爪支架
爪座
三角连杆 x 3
连杆1 x 3
连杆2 x 3
草图 x 3
MG996舵机 x 2
舵盘 x 2
推拉曲柄
推拉臂
推拉臂2
圆柱齿轮55×1.25
圆柱齿轮23×1.25
