ylu98596/telescopic-folding-robotic-arm-gripper/SW/机械手臂/机械臂手臂部分.SLDASM

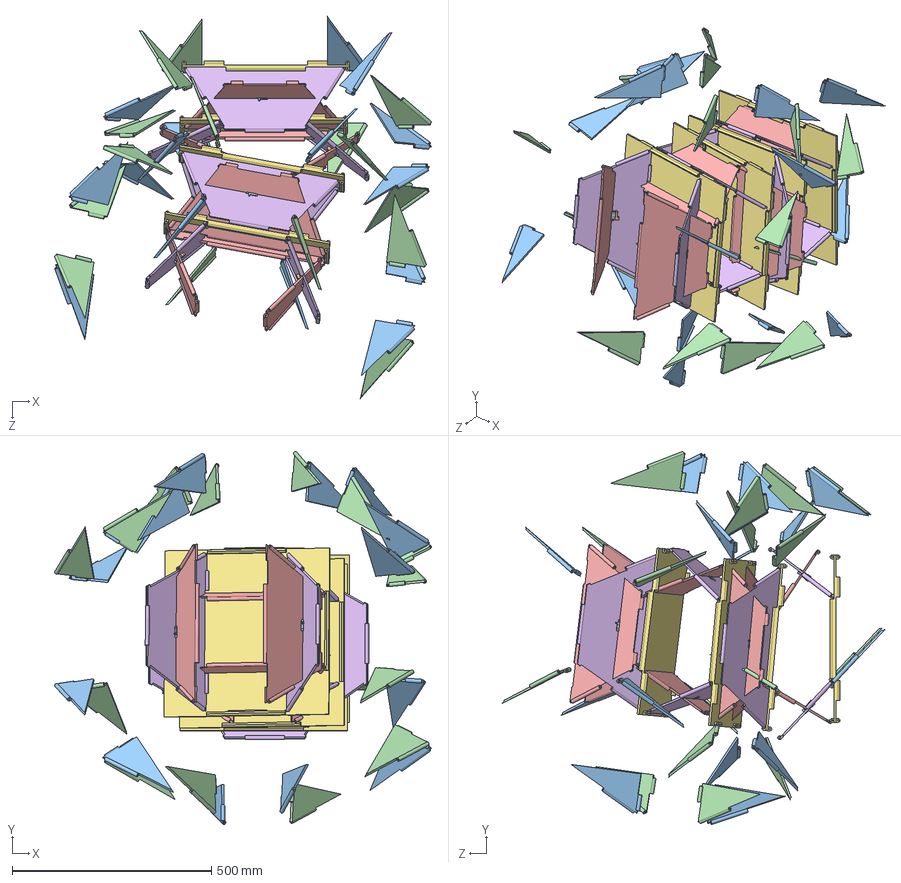
[picture p26: CAD file, 2026-10-07]
SW/机械手臂/机械臂手臂部分.SLDASM
946.0 x 936.1 x 958.6 mm
正方形中间层 x 4
梯形上 x 8
梯形下 x 8
三角上 x 16
三角下 x 16
舵机架 x 8
9g舵机 x 8
