ylu98596/telescopic-folding-robotic-arm-gripper/SW/机械手臂/折叠结构部件1.SLDASM

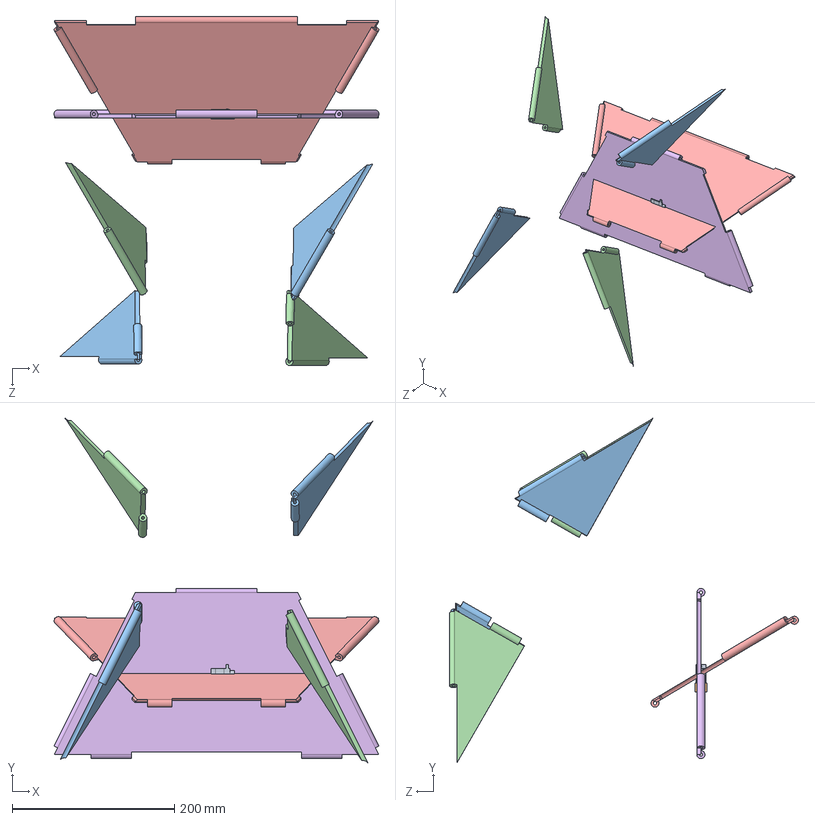
[picture p27: CAD file, 2026-10-07]
SW/机械手臂/折叠结构部件1.SLDASM
400.6 x 424.1 x 430.2 mm
梯形上
梯形下
三角上 x 2
三角下 x 2
舵机架
9g舵机
