ylu98596/telescopic-folding-robotic-arm-gripper/SW/机械夹爪/爪座.SLDPRT

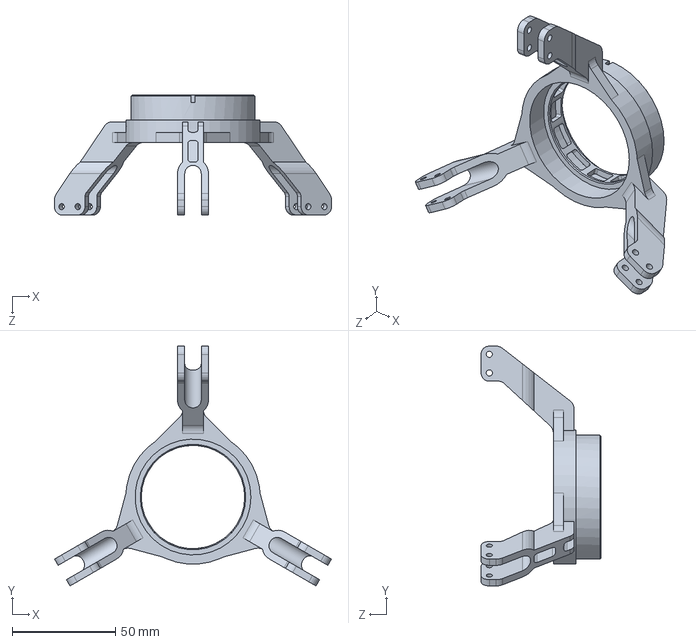
[picture p28: CAD file, 2026-10-07]
SW/机械夹爪/爪座.SLDPRT
133.9 x 116.0 x 58.0 mm
