ylu98596/telescopic-folding-robotic-arm-gripper/SW/机械夹爪/舵机及配件/MG996舵机.SLDPRT

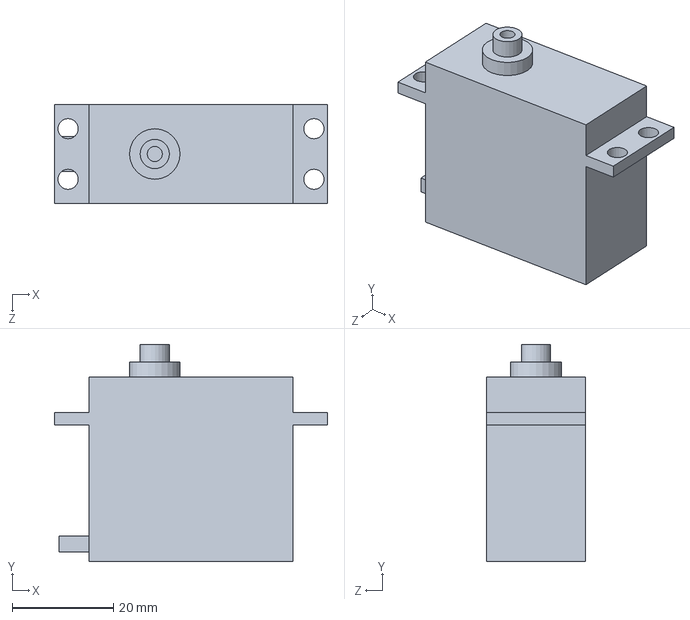
[picture p29: CAD file, 2026-10-07]
SW/机械夹爪/舵机及配件/MG996舵机.SLDPRT
54.0 x 43.0 x 19.5 mm
