ylu98596/telescopic-folding-robotic-arm-gripper/SW/机械手臂/正方形盖子.SLDPRT

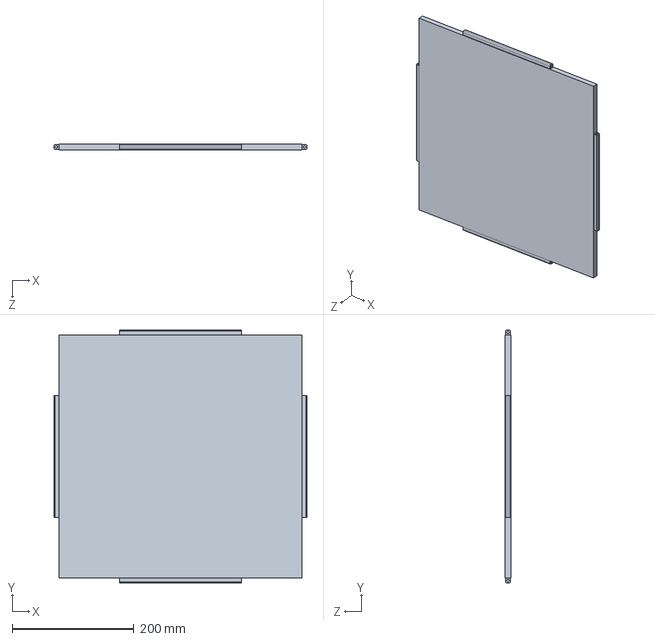
[picture p30: CAD file, 2026-10-07]
SW/机械手臂/正方形盖子.SLDPRT
416.0 x 416.0 x 10.0 mm
