ylu98596/telescopic-folding-robotic-arm-gripper/SW/机械夹爪/舵机及配件/舵盘.SLDPRT

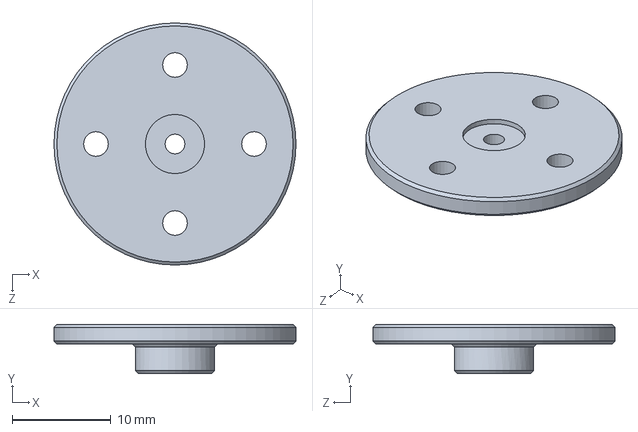
[picture p31: CAD file, 2026-10-07]
SW/机械夹爪/舵机及配件/舵盘.SLDPRT
24.5 x 5.00 x 24.5 mm
