ylu98596/telescopic-folding-robotic-arm-gripper/SW/机械夹爪/草图.SLDPRT

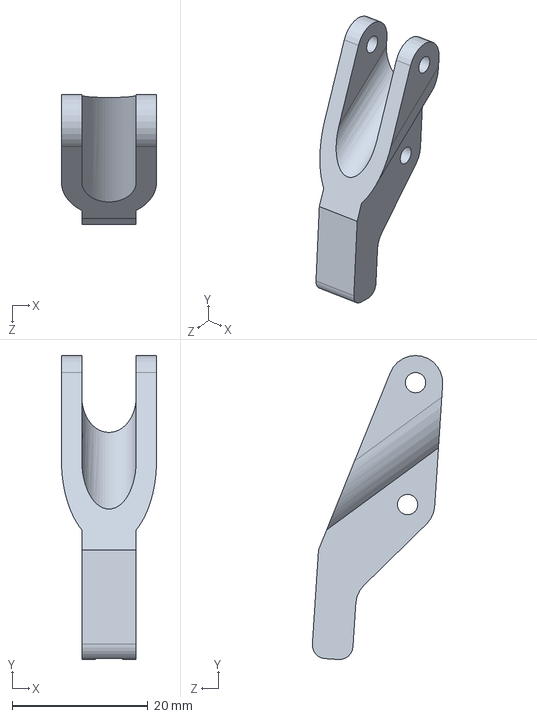
[picture p32: CAD file, 2026-10-07]
SW/机械夹爪/草图.SLDPRT
14.0 x 44.8 x 19.2 mm
