ylu98596/telescopic-folding-robotic-arm-gripper/SW/机械夹爪/连杆1.SLDPRT

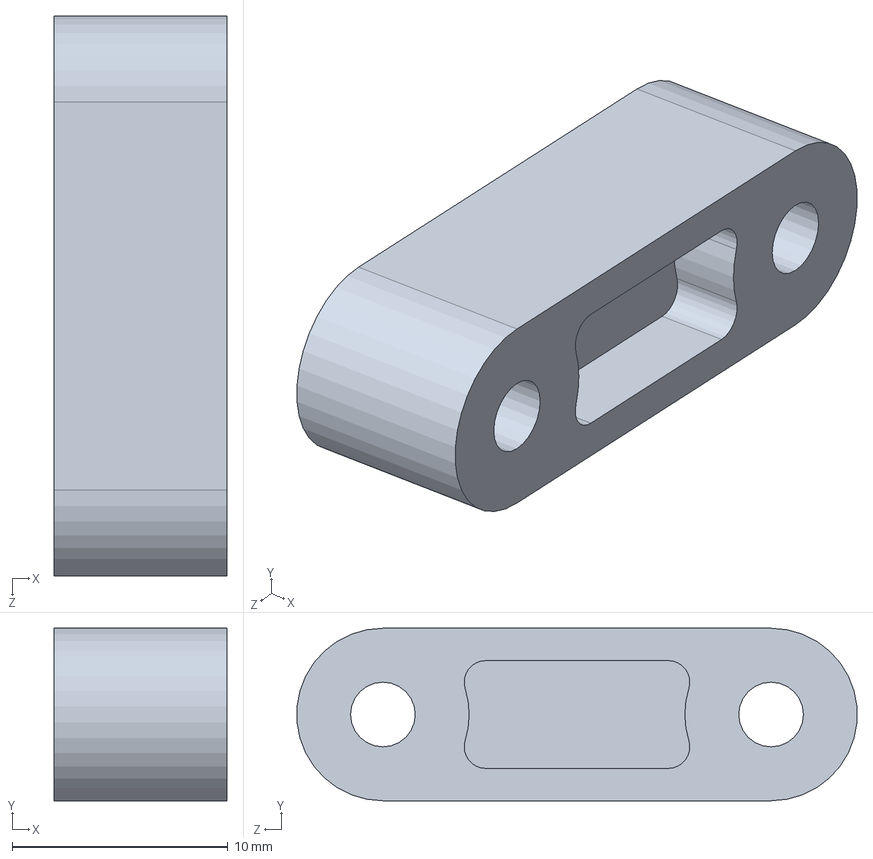
[picture p33: CAD file, 2026-10-07]
SW/机械夹爪/连杆1.SLDPRT
8.00 x 8.00 x 26.0 mm
