ylu98596/telescopic-folding-robotic-arm-gripper/SW/机械手臂/正方形中间层.SLDPRT

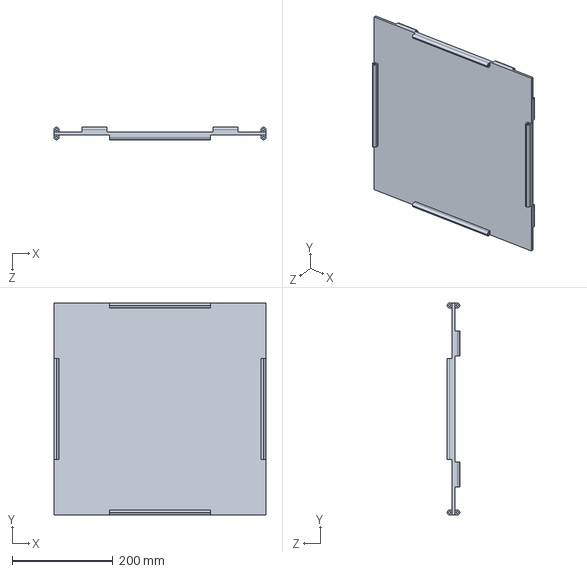
[picture p35: CAD file, 2026-10-07]
SW/机械手臂/正方形中间层.SLDPRT
420.0 x 420.0 x 25.0 mm
