ylu98596/telescopic-folding-robotic-arm-gripper/SW/机械夹爪/推拉曲柄.SLDPRT

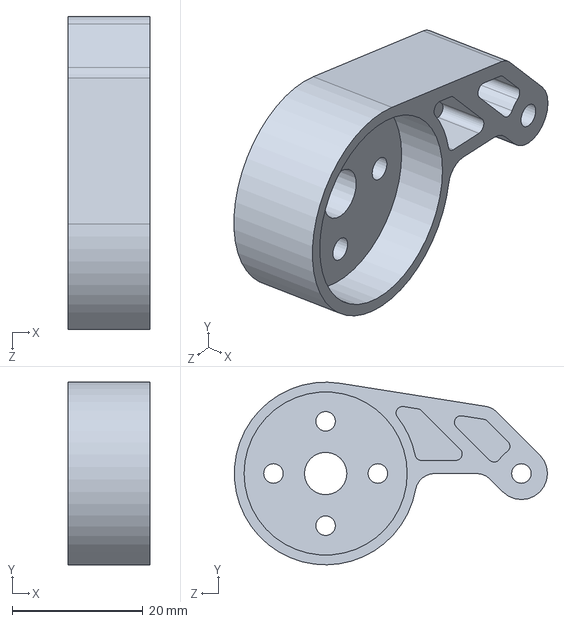
[picture p36: CAD file, 2026-10-07]
SW/机械夹爪/推拉曲柄.SLDPRT
12.5 x 28.0 x 48.0 mm
