ylu98596/telescopic-folding-robotic-arm-gripper/SW/机械夹爪/爪支架.SLDPRT

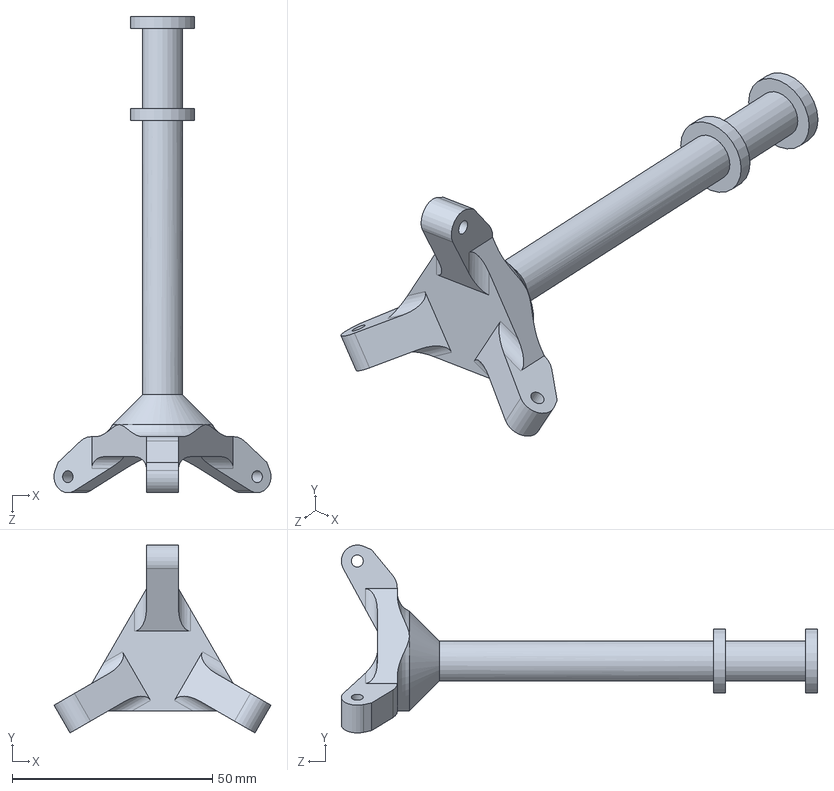
[picture p37: CAD file, 2026-10-07]
SW/机械夹爪/爪支架.SLDPRT
54.2 x 46.9 x 119.0 mm
