ylu98596/telescopic-folding-robotic-arm-gripper/SW/机械手臂/舵机架.SLDPRT

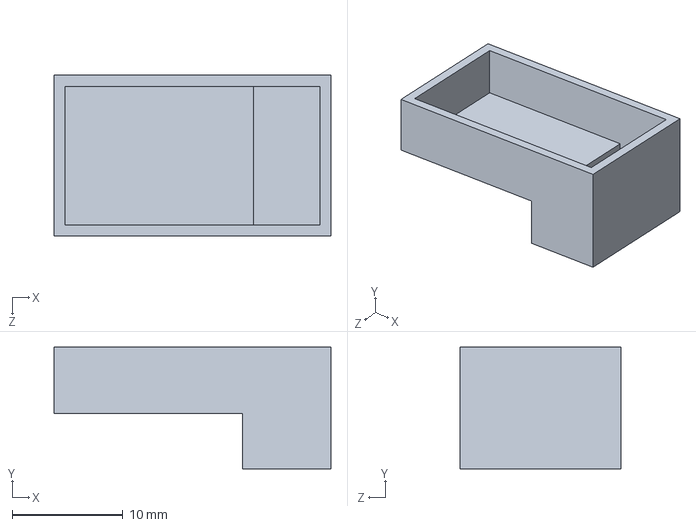
[picture p38: CAD file, 2026-10-07]
SW/机械手臂/舵机架.SLDPRT
25.0 x 11.0 x 14.5 mm
