ylu98596/telescopic-folding-robotic-arm-gripper/SW/机械夹爪/圆柱齿轮55×1.25.SLDPRT

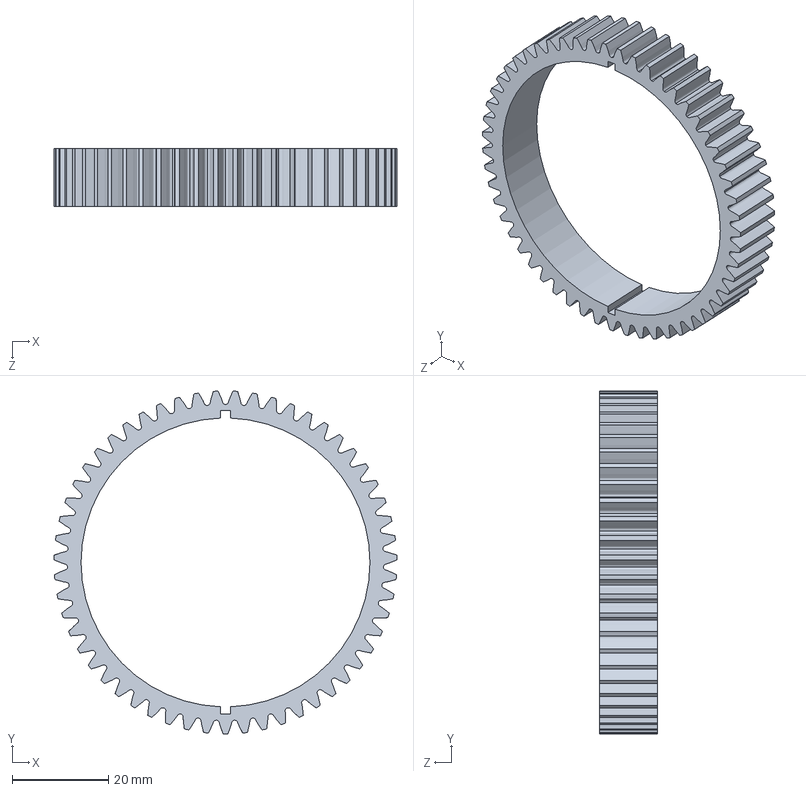
[picture p39: CAD file, 2026-10-07]
SW/机械夹爪/圆柱齿轮55×1.25.SLDPRT
71.2 x 71.2 x 12.0 mm
