ylu98596/telescopic-folding-robotic-arm-gripper/SW/机械手臂/三角上.SLDPRT

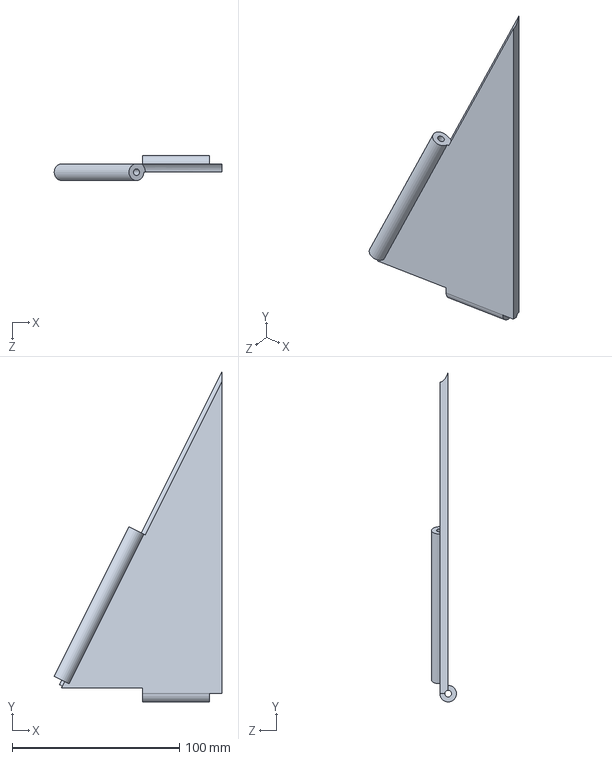
[picture p40: CAD file, 2026-10-07]
SW/机械手臂/三角上.SLDPRT
100.4 x 197.6 x 15.0 mm
