ylu98596/telescopic-folding-robotic-arm-gripper/SW/机械夹爪/连杆2.SLDPRT

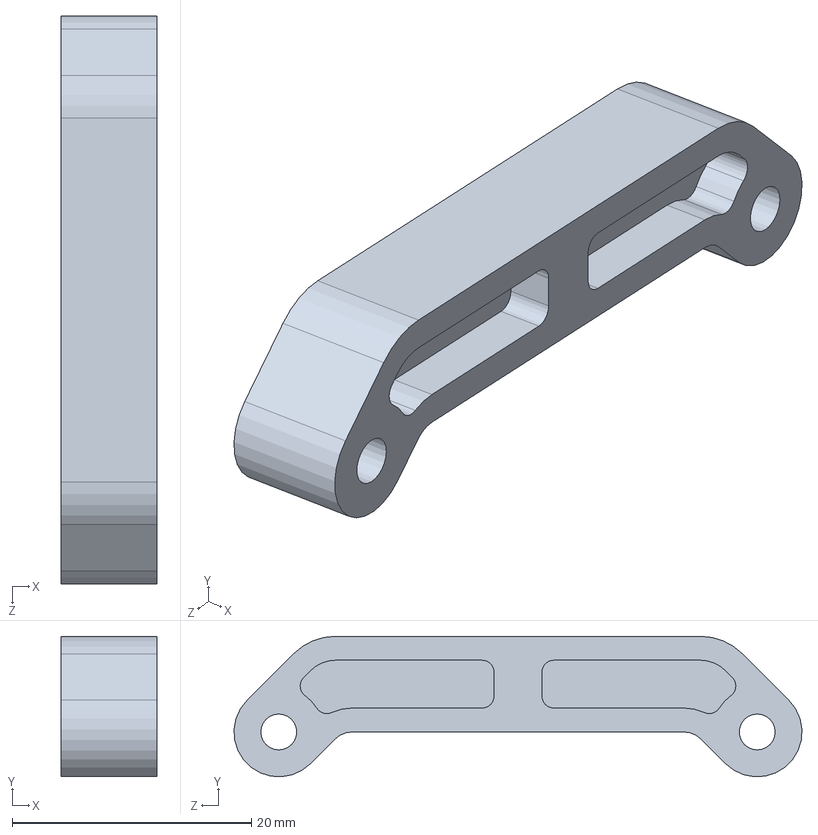
[picture p41: CAD file, 2026-10-07]
SW/机械夹爪/连杆2.SLDPRT
8.00 x 11.7 x 47.5 mm
