ylu98596/telescopic-folding-robotic-arm-gripper/SW/机械夹爪/推拉臂.SLDPRT

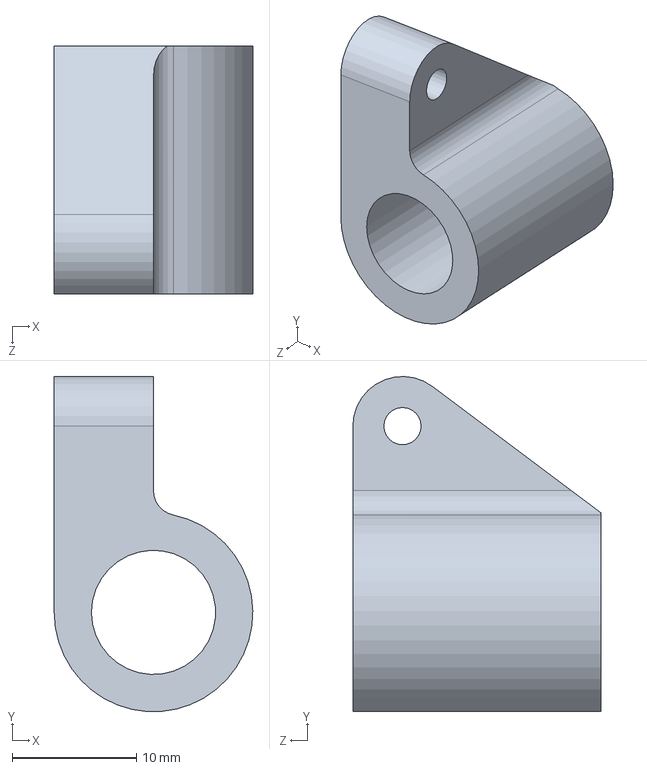
[picture p42: CAD file, 2026-10-07]
SW/机械夹爪/推拉臂.SLDPRT
16.0 x 27.0 x 20.0 mm
