ylu98596/telescopic-folding-robotic-arm-gripper/SW/机械夹爪/机架.SLDPRT

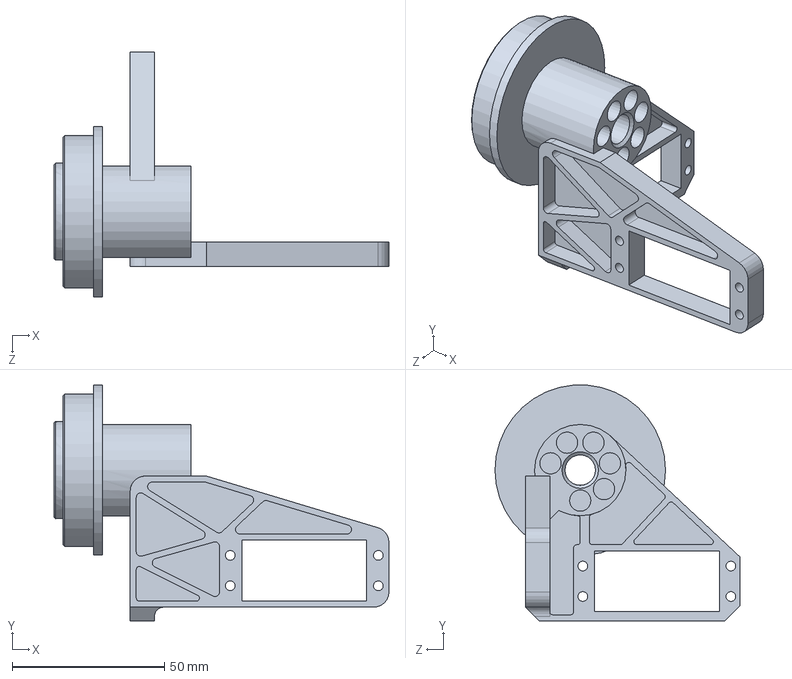
[picture p43: CAD file, 2026-10-07]
SW/机械夹爪/机架.SLDPRT
110.0 x 77.4 x 80.5 mm
