ylu98596/telescopic-folding-robotic-arm-gripper/SW/机械夹爪/三角连杆.SLDPRT

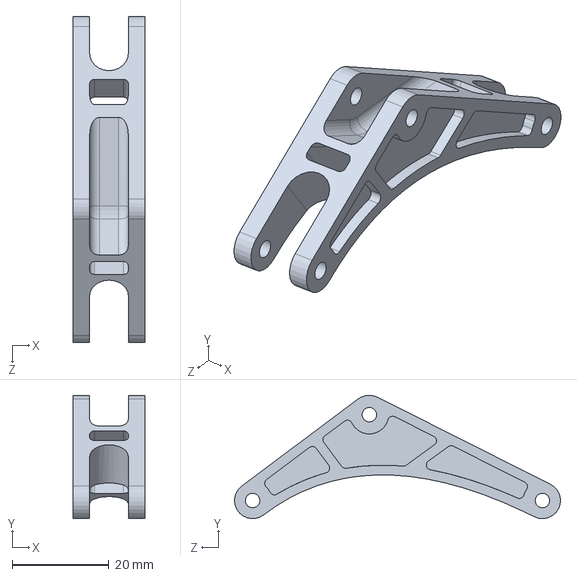
[picture p44: CAD file, 2026-10-07]
SW/机械夹爪/三角连杆.SLDPRT
15.0 x 25.5 x 67.5 mm
