ylu98596/telescopic-folding-robotic-arm-gripper/SW/机械夹爪/圆柱齿轮23×1.25.SLDPRT

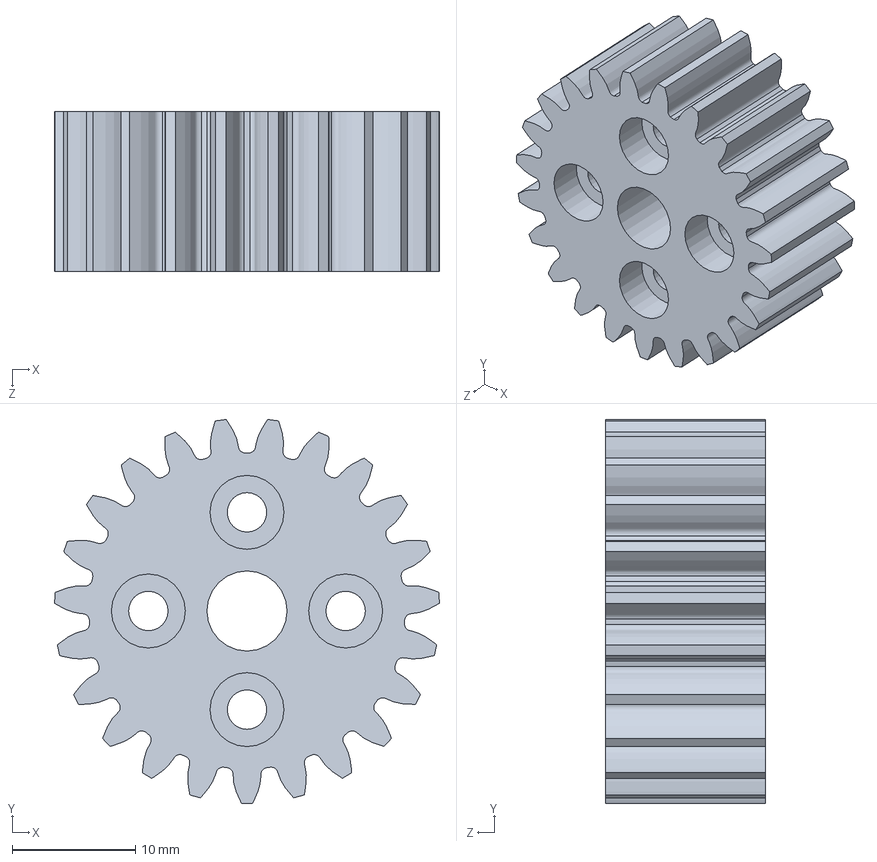
[picture p45: CAD file, 2026-10-07]
SW/机械夹爪/圆柱齿轮23×1.25.SLDPRT
31.2 x 31.2 x 13.0 mm
