ylu98596/telescopic-folding-robotic-arm-gripper/SW/机械手臂/9g舵机.SLDPRT

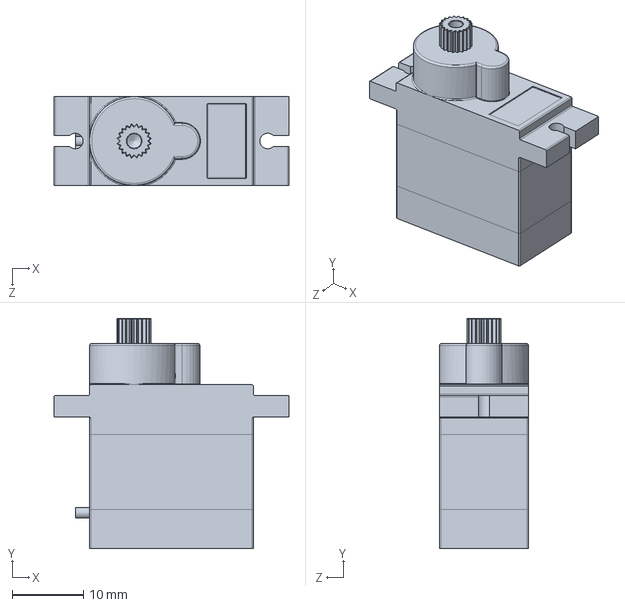
[picture p46: CAD file, 2026-10-07]
SW/机械手臂/9g舵机.SLDPRT
33.0 x 32.3 x 12.5 mm
