ylu98596/telescopic-folding-robotic-arm-gripper/SW/机械夹爪/推拉臂2.SLDPRT

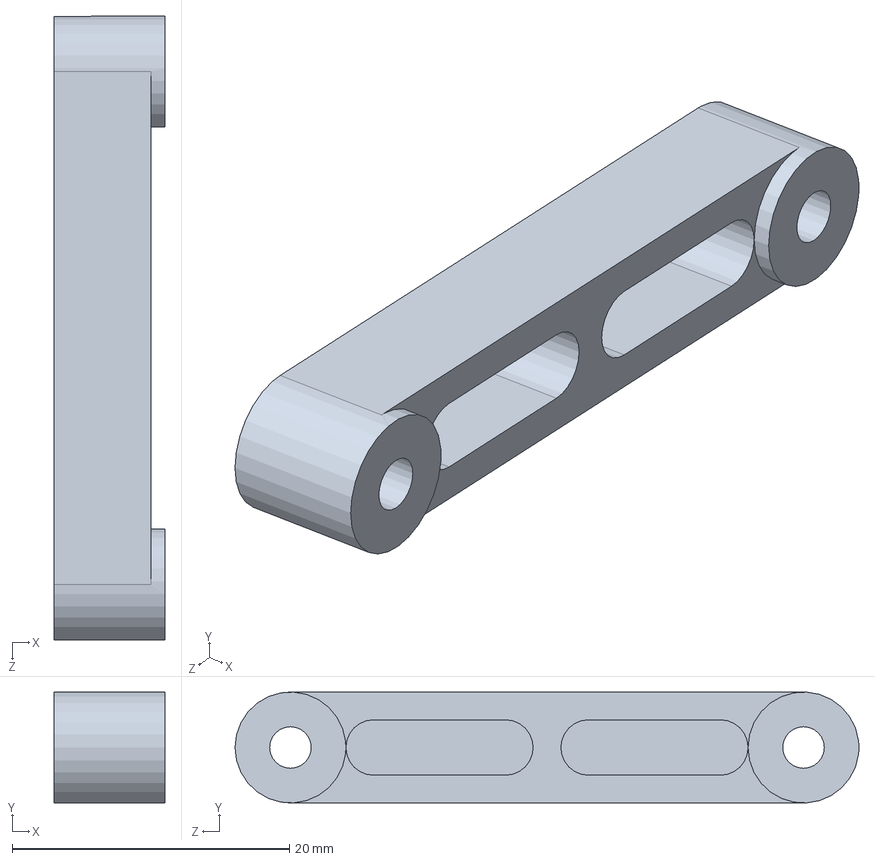
[picture p47: CAD file, 2026-10-07]
SW/机械夹爪/推拉臂2.SLDPRT
8.00 x 8.00 x 45.0 mm
