ylu98596/telescopic-folding-robotic-arm-gripper/SW/机械手臂/梯形上.SLDPRT

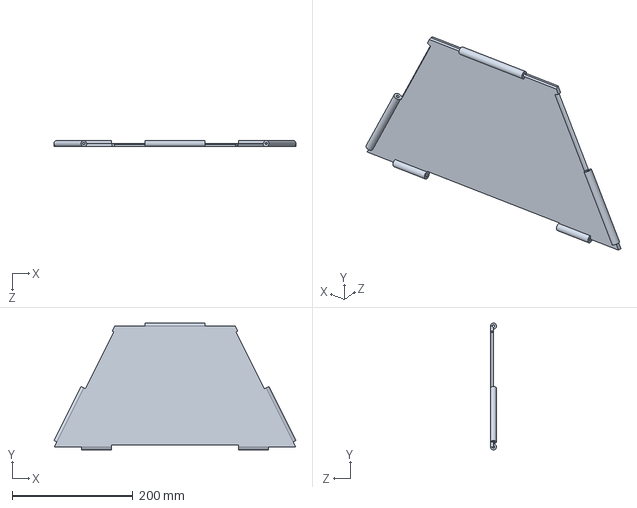
[picture p48: CAD file, 2026-10-07]
SW/机械手臂/梯形上.SLDPRT
400.6 x 210.0 x 10.0 mm
