ylu98596/telescopic-folding-robotic-arm-gripper/(list of files, cad)

Other CAD files:
SW/机械手臂/折叠机构部件第二层.SLDASM
SW/机械手臂/三角下.SLDPRT
SW/机械手臂/正方形顶盖.SLDPRT
